Z-Elektrik/LIB/Library_Listing.ods

Sheet: Export for GitHUB
Filename/Library | Component | Description | ki_keywords | Reference | Value | Footprint | Datasheet | Technology | MFG | MPN | Device_Marking | OC_LCSC | OC_MOUSER | OC_RS | OC_DISTRELEC | OC_TME | OC_FARNELL | OC_DIGIKEY | OC_SOS | Z-SYSCODE | Assembly_Note | Comment
Audio_TDK.kicad_sym | PS1240P02BT, THD, 3V, 70dB, TDK | SMD Piezo element non polarised, 70 dB (4kHz), 3V | BZ | Y | PS1240P02BT | THD_Audio_TDK:SPKADVV500W65D1220H655-2N_PS12_TDK | https://product.tdk.com/system/files/dam/doc/product/sw_piezo/sw_piezo/piezo-buzzer/catalog/piezoelectronic_buzzer_ps_en.pdf | THD | TDK | PS1240P02BT |  | C76871 |  |  |  |  | 3267212
Connector_ETH_Wurth.kicad_sym | 7499010121A, THD, RJ45 8P8C Female, transf+2xLED, Horizontal, Wurth | RJ45 8P8C, Female, with transformer, with 2xLED, 16.1x25.4x13.55mm, Horizontal | ETH,RJ45 | X | 7499010121A | THD_Connector_ETH_Wurth:ETHRJ45_8P8C_7499010121A_Wurth | https://www.we-online.com/components/products/datasheet/7499010121A.pdf | THD | Wurth Elektronik | 7499010121A | 7499010121A |  | 710-7499010121A | 735-0239 | 300-63-255 |  | 1636379 | 732-1650-ND | 194844
Capacitor_Ceramic_THD5.00_100V_20-80perc_Y5V_Generic.kicad_sym | 100n, THD 5.00mm, 100V, 20%, Y5V, Generic | Capacitor ceramic, 100V, -20..+80%, Y5V | CCAP | C | 100n/100V | THD_Capacitor_Generic:CAPRB500W50D500T250H510 |  | THD | Generic |  |  |  |  |  |  |  |  |  |  | 1019
Capacitor_Ceramic_THD_JFZ_310V_10perc_X2_JBCapacitors.kicad_sym | 100n, THD 15.00mm, 310VAC, 10%, JBC | Capacitor X2 PP Foil, 310VAC, JFZ Series | CCAP,X2 | C | 100n/310VAC | THD_Capacitor_JBCap:CAPRR1500W90L1800T600H1200 | https://www.tme.eu/Document/13ccb7880bac8bd38632e7baf71c9910/JFZ-X2.pdf | THD | JB Capacitors | JFZ0A9104K150000B
Capacitor_Elyt_SMD_50V_20perc_LowESR_FK-Series_Panasonic.kicad_sym | 100u, SMD, 50V, 20%, Low ESR, Panasonic | Capacitor electrolytic, 50V, Low ESR, 2000-5000Hrs @105Â°C, FK Series | ECAP | C | 100u/50V | SMD_Capacitor_Elyt_Panasonic:CAPAE830X1020N_Panasonic-F | https://industrial.panasonic.com/cdbs/www-data/pdf/RDE0000/ABA0000C1181.pdf | SMD | Panasonic | EEEFK1H101P | 100 50 FK | C178548 | 667-EEE-FK1H101P | 537-0540 | 167-23-868 | EEEFK1H101P | 9695958 | PCE3809CT-ND |  | 6053
Capacitor_Elyt_THD2.50_63V_20perc_105C_1000H_Generic.kicad_sym | 47u, THD 2.5, 63V, 20%, Generic | Capacitor electrolytic, 63V, 20%, 1000Hrs @105Â°C | ECAP | C | 47u/63V | THD_Capacitor_Generic:CAPPRD250W70D630H1100 |  | THD | Generic |  |  |  |  |  |  |  |  |  |  | 678
Connector_USB_Ninigi.kicad_sym | USBB-BV, THD, USB-2.0-B, Vertical, Ninigi | PCB Connector, USB-2.0, Type B, 12x11x16.1mm, Vertical | USB | X | 2411 05 | THD_Connector_USB_Lumberg:CONNUSBV4W190P250H1610N-241105_Lumberg | https://www.tme.eu/Document/ad321a3664afd6b939251b221569d870/USBB-BV.pdf | THD | Ninigi | USBB-BV |  |  |  |  |  | USBB-BV |  |  |  | 2879
Diode_ONSemi.kicad_sym | ESD5Z3.3T1G, SOD523, Bidir, 3.3V, ON | ESD diode protection, Vrwm:3.3V, Vbr: 5.0V, It:1mA, Ppk:120W | TVS | Z | ESD5Z3.3T1G | SMD_Semiconductor_Generic:SODFL1608X70N_SOD-523_CASE502_ON | https://www.onsemi.com/pdf/datasheet/esd5z2.5t1-d.pdf | SMD | ON Semiconductor | ESD5Z3.3T1G | ZE | C61148 | 863-ESD5Z3.3T1G | 689-9985 |  | ESD5Z3.3T1G | 2317508 | ESD5Z3.3T1GOSCT-ND | 71556 | 8652
Diode_ONSemi.kicad_sym | LL4148, DO213AC, Signal diode, 100V, 200mA, ON | Diode Small Signal, Vrrm: 100V, If: 200mA, Ir<25nA, Vf<1.0V @10mA | D | D | LL4148 | SMD_Semiconductor_Generic:DIOMELF3414N_DO213AC_MiniMELF | https://www.tme.eu/Document/719e3c29769cb8dee605f959a3db8a4a/LL4148.pdf | SMD | ON Semiconductor | LL4148 |  | C84135 | 512-LL4148 | 670-8826 | 302-30-889 | LL4148-FAI | 2101203 | LL4148FSCT-ND | T372589 | 1138
Fuse_Eska.kicad_sym | 522.522, Mech, Glass fuse, 3.15A, 250VAC, Eska | Fuse cylindrical glass, Time-Lag, 5x20mm, 250VAC | Fuse | F | T3,15A |  | https://www.tme.eu/Document/9128035b9d50f6bbcf0a57f0845d1c57/22.pdf | Mechanical | Eska | 522.522 |  |  |  |  |  |  |  |  |  | 915
GDT_Epcos.kicad_sym | B88069X9590B502, THD, Gas disch. tube, 150V, 4kA, Epcos | Surge Arrester, Fast, 150V, 10kA, -40 to 125Â°C | GDT | Z | B88069X9590B502 | THD_GDT_Epcos:GDTAD880W100L1000D800-3N_Epcos | https://www.farnell.com/datasheets/3954723.pdf | THD | Epcos | B88069X9590B502 |  |  |  |  |  |  | 2529338
Header_Amphenol.kicad_sym | 77313-818-16LF, THD, 2x8pin, 2.54mm, h{colon}8.6mm, Gold, Male, Amphenol | Header Pins Dual Male, 2x8 pin, 2.54, h:8.6mm, Gold, THD | CON16,HEADER2x8 | X | 77313-818-16LF | THD_Header_Connfly:HDRV16W64P254H860N_2X8_PADC+R_170_170H100 | https://www.tme.eu/Document/e749bc1109c319ebf4eb6c9c60781caa/77313-818-XXLF.pdf | THD | Amphenol | 77313-818-16LF |  | C3338979 | 649-77313-818-16LF |  |  | 77313-818-16LF | 3882077 | 609-5139-ND |  | 1591
IC_Interface_NXP.kicad_sym | PCA9552BS, HVQFN24, 16-bit LED Driver, I2C, NXP | 16-bit I2C LED Driver 100mA with programmable blink rates, 5V, with A0,A1,A2 |  | U | PCA9552BS |  | https://www.nxp.com/docs/en/data-sheet/PCA9552.pdf | SMD | NXP | PCA9552BS |  | C2678763 | 771-PCA9552BS-T |  |  |  | 2775950 | 568-3389-1-ND
IC_Interface_NXP.kicad_sym | PCA9552D, SO24, 16-bit LED Driver, I2C, NXP | 16-bit I2C LED Driver 100mA with programmable blink rates, 5V, with A0,A1,A2 |  | U | PCA9552D |  | https://www.nxp.com/docs/en/data-sheet/PCA9552.pdf | SMD | NXP | PCA9552D |  | C2157803 | 771-PCA9552D-T |  |  | PCA9552D | 2985179 | 568-PCA9552D118CT-ND
IC_Interface_NXP.kicad_sym | PCA9552PW, TSSOP24, 16-bit LED Driver, I2C, NXP | 16-bit I2C LED Driver 100mA with programmable blink rates, 5V, with A0,A1,A2 |  | U | PCA9552PW |  | https://www.nxp.com/docs/en/data-sheet/PCA9552.pdf | SMD | NXP | PCA9552PW |  | C129513 | 771-PCA9552PW-T |  |  | PCA9552PW | 2775951 | 568-11924-1-ND | 287813
IC_Interface_NXP.kicad_sym | PCA9555D, SO24, 16-bit expander, I2C, NXP | 16-bit I2C expander with Interrupt |  | U | PCA9555D |  | http://www.nxp.com/documents/data_sheet/PCA9555.pdf | SMD | NXP | PCA9555D | PCA9555 |  | 771-PCA9555D112 |  | 663227 | PCA9555D | 8906076 |  |  | 9085
IC_Interface_NXP.kicad_sym | PCA9555PW, TSSOP24, 16-bit expander, I2C, NXP | 16-bit I2C expander with Interrupt |  | U | PCA9555PW |  | http://www.nxp.com/documents/data_sheet/PCA9555.pdf | SMD | NXP | PCA9555PW | PCA9555 |  |  |  |  |  |  |  |  | 7494
IC_Interface_NXP.kicad_sym | PCA9622DR, TSSOP32, 16-bit LED Driver, I2C, NXP | 16-bit I2C LED Driver 100mA, 40V |  | U | PCA9622 |  | https://www.nxp.com/docs/en/data-sheet/PCA9622.pdf | SMD | NXP | PCA9622DR |  |  | 771-PCA9622DR,118 |  |  |  | 1854075
IC_Interface_NXP.kicad_sym | PCA9633DP1, TSSOP8, 4-bit LED Driver, I2C, NXP | 4-bit I2C LED Driver 100mA, 40V |  | U | PCA9633DP1 |  | http://www.nxp.com/documents/data_sheet/PCA9633.pdf | SMD | NXP | PCA9633DP1 |  |  | 771-PCA9633DP1-T | 510-976
IC_Interface_NXP.kicad_sym | PCA9633DP2, TSSOP10, 4-bit LED Driver, I2C, NXP | 4-bit I2C LED Driver 100mA, 40V, With A0, A1 |  | U | PCA9633DP2 |  | http://www.nxp.com/documents/data_sheet/PCA9633.pdf | SMD | NXP | PCA9633DP2 |  |  | 771-PCA9633DP2-T | 510-908
IC_Interface_NXP.kicad_sym | PCA9952TW, HTSSOP28, 16-bit LED Driver, I2C, ExtRST, NXP | 16-bit I2C LED Driver 100mA, 40V, with Ext.RSET and OE | I2C,LED | U | PCA9952TW | SMD_IC_Generic:SOP65P640X110-29N_HTSSOP28_SOT1172-2_MO-153 | http://www.nxp.com/documents/data_sheet/PCA9952_PCA9955.pdf | SMD | NXP | PCA9952TW |  |  | 771-PCA9952TW118
IC_Interface_NXP.kicad_sym | PCA9955BTW, HTSSOP28, 16-bit LED Driver, I2C, ExtRST, NXP | 16-bit I2C LED Driver 57mA, 20V, with Ext.RSET | I2C,LED | U | PCA9955BTW | SMD_IC_Generic:SOP65P640X110-29N_HTSSOP28_SOT1172-2_MO-153 | https://www.nxp.com/docs/en/data-sheet/PCA9952_PCA9955.pdf | SMD | NXP | PCA9955BTWJ |  | C2678563 | 771-PCA9955BTWJ |  |  |  | 2759859 | 568-12427-1-ND | T547227 | 11090
IC_Interface_NXP.kicad_sym | PCA9955TW, HTSSOP28, 16-bit LED Driver, I2C, ExtRST, NXP | 16-bit I2C LED Driver 57mA, 40V, with Ext.RSET | I2C,LED | U | PCA9955TW | SMD_IC_Generic:SOP65P640X110-29N_HTSSOP28_SOT1172-2_MO-153 | https://www.nxp.com/docs/en/data-sheet/PCA9952_PCA9955.pdf | SMD | NXP | PCA9955BTWJ |  |  | 771-PCA9955TWQ900118 |  |  |  | 2890539 | 2156-PCA9955TW/S911118-ND
IC_Interface_STM.kicad_sym | ST3232CDR, SO16, 232 Transceiver, 400kbps, 3-5V, STM | 3-5V, 400 kbps RS-232 transceiver, 0 to 70Â°C | 232 | U | ST3232CDR | SMD_IC_STM:SOIC127P700X200-16N_SO-16_STM | https://www.farnell.com/datasheets/1766333.pdf | SMD | STMicroelectronics | ST3232CDR |  | C165465 | 511-ST3232CDR | 415-2105 | 303-74-345 | ST3232CDR | 2463693 | 497-3731-1-ND | T1106484
IC_Interface_STM.kicad_sym | ST3232EBDR, SO16, 232 Transceiver, 400kbps, 3-5V, STM | 3-5V, 400 kbps RS-232 transceiver, ESD, -40 to 85Â°C | 232 | U | ST3232EBDR | SMD_IC_STM:SOIC127P700X200-16N_SO-16_STM | https://www.tme.eu/Document/de702572cb81736231cab73a6afbf9f9/ST3232EB.pdf | SMD | STMicroelectronics | ST3232EBDR |  | C970561 | 511-ST3232EBDR | 426-099 |  | ST3232EBDR | 1467753 | 497-6996-1-ND | T1225455
IC_Interface_STM.kicad_sym | ST3485EBDR, SO8, 485/422 Transceiver, 3.3V, STM | 3.3V, 15 kV ESD protected, up to 12 Mbps RS-485/RS-422 transceiver, -40 to 85 Â°C | 485 | U | ST3485EBDR | SMD_IC_Generic:SOIC127P600X175-8N_SO-8_MS-012 | http://www.st.com/st-web-ui/static/active/en/resource/technical/document/datasheet/CD00003137.pdf | SMD | STMicroelectronics | ST3485EBDR | 3485EB | C75809 | 511-ST3485EBDR |  |  | ST3485EBD | 2253266 | 516-3164-5-ND | W008452 | 9425
IC_Interface_STM.kicad_sym | ST3485ECDR, SO8, 485/422 Transceiver, 3.3V, STM | 3.3V, 15 kV ESD protected, up to 12 Mbps RS-485/RS-422 transceiver, 0 to 70 Â°C | 485 | U | ST3485ECDR | SMD_IC_Generic:SOIC127P600X175-8N_SO-8_MS-012 | http://www.st.com/st-web-ui/static/active/en/resource/technical/document/datasheet/CD00003137.pdf | SMD | STMicroelectronics | ST3485ECDR | 3485EC | C81185 | 511-ST3485ECDR | 103-2150 |  | ST3485ECDR | 1842628 | 497-6540-1-ND | 134354
IC_Interface_STM.kicad_sym | ST485EBDR, SO8, 485/422 Transceiver, 5V, 5Mbps, STM | 5V, 15 kV ESD protected, 5 Mbps RS-485/RS-422 transceiver, - 40 to 85 Â°C | 485 | U | ST485EBDR | SMD_IC_Generic:SOIC127P600X175-8N_SO-8_MS-012 | https://www.st.com/resource/en/datasheet/st485eb.pdf | SMD | STMicroelectronics | ST485EBDR | 3485EB | C81186 | 511-ST485EBDR | 426-073 | 301-70-656 | ST485EBDR | 1467755 | 497-2083-1-ND | T1228758
IC_Interface_STM.kicad_sym | ST485ECDR, SO8, 485/422 Transceiver, 5V, 5Mbps, STM | 5V, 15 kV ESD protected, 5 Mbps RS-485/RS-422 transceiver, 0 to 70 Â°C | 485 | U | ST485ECDR | SMD_IC_Generic:SOIC127P600X175-8N_SO-8_MS-012 | https://www.st.com/resource/en/datasheet/st485eb.pdf | SMD | STMicroelectronics | ST485ECDR | 485EC | C283405 | 511-ST485ECDR | 686-4904 | 301-70-657 | ST485ECDR | 1842627 | 497-3735-1-ND | T1259145
IC_MCU32_NXP.kicad_sym | LPC5512JBD64, HTQFP64, ARM Cortex-M33, 64kB/48kB, 150MHz, NXP | 32-bit ARM Cortex-M33 microcontroller, 150MHz, 64kB Flash, 48kB SRAM, USB FS, CAN2.0, 2 Msps 16b ADC, 36 GPIO | MCU | U | LPC5512JBD64 | SMD_IC_NXP:QFP50P1200X1200X120-65N_HTQFP64_SOT855-5_NXP | https://www.nxp.com/part/MCXC242VLH | SMD | NXP | LPC5512JBD64 | LPC5512 JBD64 |  | 771-LPC5512JBD64E |  |  |  | 3385149 | 568-LPC5512JBD64YCT-ND
IC_MCU32_NXP.kicad_sym | LPC5514JBD64, HTQFP64, ARM Cortex-M33, 128kB/80kB, 150MHz, NXP | 32-bit ARM Cortex-M33 microcontroller, 150MHz, 128kB Flash, 80kB SRAM, USB FS+HS, CAN FD, 2 Msps 16b ADC, 36 GPIO | MCU | U | LPC5514JBD64 | SMD_IC_NXP:QFP50P1200X1200X120-65N_HTQFP64_SOT855-5_NXP | https://www.nxp.com/part/MCXC242VLH | SMD | NXP | LPC5514JBD64 | LPC5514 JBD64 | C1012832 | 771-LPC5514JBD64E |  |  |  | 3385147 | 568-LPC5514JBD64YCT-ND,568-LPC5514JBD64K-ND,568-LPC5514JBD64E-ND
IC_MCU32_NXP.kicad_sym | LPC5516JBD100, HTQFP100, ARM Cortex-M33, 256kB/96kB, 150MHz, NXP | 32-bit ARM Cortex-M33 microcontroller, 150MHz, 256kB Flash, 96kB SRAM, USB FS+HS, CAN FD, 2 Msps 16b ADC, 64 GPIO | MCU | U | LPC5516JBD100 | SMD_IC_NXP:QFP50P1600X1600X160-101N_HLQFP100_SOT1570-3_NXP | https://www.nxp.com/docs/en/nxp/data-sheets/LPC55S1x_LPC551x_DS.pdf | SMD | NXP | LPC5516JBD100 | LPC5516JBD100 | C5194658 | 771-LPC5516JBD100K |  |  | LPC5516JBD100E | 3385143 | 568-LPC5516JBD100K-ND | T1111149
IC_MCU32_NXP.kicad_sym | LPC5516JBD64, HTQFP64, ARM Cortex-M33, 256kB/96kB, 150MHz, NXP | 32-bit ARM Cortex-M33 microcontroller, 150MHz, 256kB Flash, 96kB SRAM, USB FS+HS, CAN FD, 2 Msps 16b ADC, 36 GPIO | MCU | U | LPC5516JBD64 | SMD_IC_NXP:QFP50P1200X1200X120-65N_HTQFP64_SOT855-5_NXP | https://www.nxp.com/docs/en/nxp/data-sheets/LPC55S1x_LPC551x_DS.pdf | SMD | NXP | LPC5516JBD64 | LPC5516 JBD64 | C1012835 | 771-LPC5516JBD64K,771-LPC5516JBD64E |  |  |  | 3385145 | 568-LPC5516JBD64E-ND,568-LPC5516JBD64K-ND,568-LPC5516JBD64YCT-ND |  | 12734
IC_MCU32_NXP.kicad_sym | LPC5528JBD64, HTQFP64, ARM Cortex-M33, 512kB/256kB, 150MHz, NXP | 32-bit ARM Cortex-M33 microcontroller, 150MHz, 512kB Flash, 256kB SRAM, USB FS+HS, SDIO, 1 Msps 16b ADC, 36 GPIO | MCU | U | LPC5528JBD64 | SMD_IC_NXP:QFP50P1200X1200X120-65N_HTQFP64_SOT855-5_NXP | https://www.nxp.com/part/MCXC242VLH | SMD | NXP | LPC5528JBD64 | LPC5528 JBD64 |  | 771-LPC5528JBD64E,771-LPC5528JBD64Y,771-LPC5528JBD64K |  |  | LPC5528JBD64E,LPC5528JBD64K,LPC5528JBD64Y | 3265622 | 568-LPC5528JBD64E-ND
IC_MCU32_NXP.kicad_sym | LPC824M201JDH20, TSSOP20, ARM Cortex-M0, 32kB/8kB, NXP | 32-bit ARM Cortex-M0 microcontroller, 32kB flash, 8kB SRAM, 16 GPIO | MCU | U | LPC824M201JDH20 | SMD_IC_Generic:SOP65P640X110-20N_TSSOP-20 | http://www.nxp.com/documents/data_sheet/LPC82X.pdf | SMD | NXP | LPC824M201JDH20 |  | C86812 |  |  |  |  |  |  |  | 12213
IC_MCU32_NXP.kicad_sym | LPC824M201JHI33, HVQFN32, ARM Cortex-M0, 32kB/8kB, 30MHz, NXP | 32-bit ARM Cortex-M0 microcontroller, 30MHz, 32kB flash, 8kB SRAM, 29 GPIO | MCU | U | LPC824M201JHI33 | SMD_IC_NXP:QFN50P500X500X100-33N_HVQFN32_NXP | https://www.nxp.com/docs/en/data-sheet/LPC82X.pdf | SMD | NXP | LPC824M201JHI33Y | 824M | C528755 | 771-LPC824M201JHI33Y |  |  |  | 2890181 | 568-13786-1-ND
IC_MCU32_NXP.kicad_sym | LPC844M201JHI33, HVQFN32, ARM Cortex-M0, 64kB/8kB, 30MHz, NXP | 32-bit ARM Cortex-M0 microcontroller, 30MHz, 64kB flash, 8kB SRAM, 29 GPIO | MCU | U | LPC844M201JHI33 | SMD_IC_NXP:QFN50P500X500X100-33N_HVQFN32_NXP |  | SMD | NXP | LPC844M201JHI33 | 844M | C2054839 | 771-LPC844M201JHI33Y |  |  |  | 2985173 | 568-LPC844M201JHI33YCT-ND
IC_MCU32_NXP.kicad_sym | LPC845M301JHI33, HVQFN32, ARM Cortex-M0, 64kB/16kB, 30MHz, NXP | 32-bit ARM Cortex-M0 microcontroller, 30MHz, 64kB flash, 16kB SRAM, 29 GPIO | MCU | U | LPC845M301JHI33 | SMD_IC_NXP:QFN50P500X500X100-33N_HVQFN32_NXP |  | SMD | NXP | LPC845M301JHI33Y | 845M | C2052902 | 771-LPC845M301JHI33Y |  |  |  | 2985175 | 568-14091-1-ND
IC_MCU32_NXP.kicad_sym | LPC865M201JHI33, HVQFN32, ARM Cortex-M0, 64kB/8kB, 60MHz, NXP | 32-bit ARM Cortex-M0 microcontroller, 60MHz, 64kB flash, 8kB SRAM, 29 GPIO | MCU | U | LPC865M201JHI33 | SMD_IC_NXP:QFN50P500X500X100-33N_HVQFN32_NXP | https://www.nxp.com/products/processors-and-microcontrollers/arm-microcontrollers/general-purpose-mcus/lpc800-arm-cortex-m0-plus-/lpc860-32-bit-arm-cortex-m0-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 | SMD | NXP | LPC865M201JHI33/0E | 865M |  | 771-PC865M201JHI330E |  |  |  |  | 568-LPC865M201JHI33/0E-ND
IC_MCU32_NXP.kicad_sym | MCXC242VFM, QFN32, ARM Cortex-M0+, 64kB/16kB, 48MHz, NXP | 32-bit ARM Cortex-M0+ microcontroller, 48MHz, 64kB Flash, 16kB SRAM, USB, 24 GPIO | MCU | U | MCXC242VFM | SMD_IC_NXP:QFN50P500X500X58-33N_HUQFN32_NXP | https://www.nxp.com/part/MCXC242VFM | SMD | NXP | MCXC242VFM | MC242M |  | 771-MCXC242VFM |  |  |  | 4557994 | 568-MCXC242VFM-ND
IC_MCU32_NXP.kicad_sym | MCXC242VLH, LQFP64, ARM Cortex-M0+, 64kB/16kB, 48MHz, NXP | 32-bit ARM Cortex-M0+ microcontroller, 48MHz, 64kB Flash, 16kB SRAM, USB, 51 GPIO | MCU | U | MCXC242VLH | SMD_IC_NXP:QFP50P1200X1200X120-65N_HTQFP64_SOT855-5_NXP | https://www.nxp.com/part/MCXC242VLH | SMD | NXP | MCXC242VLH | MCXC242/VLH |  | 771-MCXC242VLH |  |  |  | 4557993 | 568-MCXC242VLH-ND
Opto_Ampul.kicad_sym | AM4140, THD, Rectangle 2x5mm, Flat, Yellow, 20mA, Ampul | LED, Rectangle 2x5x7mm, Yellow 585nm, Lens:Flat, Water Clear, No-Flange, 600mcd@20mA, 160Â°, Vf: 1.8-2.2V@20mA | LED | D | AM4140-Yellow | THD_Opto_Generic:LEDRR254W50L500T200H700-2N_FLT_NF_LL600_White | https://www.ampul.eu/cs/led-obdelnikove/2973-led-dioda-obdelnikova-2x5x7mm-zluta-cira | THD |  |  |  |  |  |  |  |  |  |  |  | 1722 |  | Ampul.eu->order code: AM4140
Opto_Ampul.kicad_sym | AM8774, THD, Rectange 2x5mm, Flat, Green, 20mA, Ampul | LED, Rectangle 2x5x7mm, Green 517nm, Lens:Flat, Water Clear, No-Flange, 1500mcd@20mA, 160Â°, Vf: 3.0-3.4V@20mA | LED | D | AM8774-Green | THD_Opto_Generic:LEDRR254W50L500T200H700-2N_FLT_NF_LL600_White | https://www.ampul.eu/cs/led-obdelnikove/2971-led-dioda-obdelnikova-2x5x7mm-zelena-cira | THD |  |  |  |  |  |  |  |  |  |  |  | 3928 |  | Ampul.eu->order code: AM8774
Opto_Ampul.kicad_sym | AM8957, THD, Rectange 2x5mm, Flat, Red, 20mA, Ampul | LED, Rectangle 2x5x7mm, Red 625nm, Lens:Flat, Water Clear, No-Flange, 800mcd@20mA, 160Â°, Vf: 1.8-2.2V@20mA | LED | D | AM8957-Red | THD_Opto_Generic:LEDRR254W50L500T200H700-2N_FLT_NF_LL600_White | https://www.ampul.eu/cs/led-obdelnikove/2975-led-dioda-obdelnikova-2x5x7mm-cervena-cira | THD |  |  |  |  |  |  |  |  |  |  |  | 5261 |  | Ampul.eu->order code: AM8957
IC_Power_TopPowerASIC.kicad_sym | TP5400, ESOP8, Li-lon Battery Charger, 0.13-1.0A, VBat 3.8V, TopPowerAsic | Li-Ion Charger and boost, Bat: 4.2V, Vi: max 9V, Vo: 5V, 0.13-1.0A, 400kHz, -40 to 85Â°C | IC | U | TP5400 | SMD_IC_TopPowerASIC:SOIC127P600X175-9N_ESOP-8_TOPPWR | http://toppwr.com/uploadfile/file/20240913/66e3d16e96d7b.pdf | SMD | NanJing Top Power ASIC Corp. | TP5400-ESOP8 |  | C2891434
IC_Power_TopPowerASIC.kicad_sym | TP5410, ESOP8, Li-lon Battery Charger, 0.13-1.0A, VBat 3.8V, TopPowerAsic | Li-Ion Charger and boost, Bat: 4.2V, Vi: max 10V, Vo: 5V, 0.13-1.0A, 400kHz, -40 to 85Â°C | IC | U | TP5410 | SMD_IC_TopPowerASIC:SOIC127P600X175-9N_ESOP-8_TOPPWR | http://www.toppwr.com/uploadfile/file/20240913/66e3a6134c8db.pdf | SMD | NanJing Top Power ASIC Corp. | TP5410-ESOP8 |  | C2891434
IC_Socket_Connfly.kicad_sym | DS1001-01-32BT1WSF6S-JKB, IC Socket, DIP32, ConnFly | IC Socket, DIP32, RM2.54mm, Width:15.24mm, Height:4.7mm, with Central Support, Precise, Gold Plating 3um | IC,Socket | U |  | THD_IC_Socket_Connfly:DIPS1524W50P254L4064H470Q32-N_Connfly | https://www.tme.eu/Document/4e675710cbbe7d2c7527f172074a3ea6/DS1001-01.pdf | THD | ConnFly | DS1001-01-32BT1WSF6S-JKB |  | C72128 |  |  |  |  |  |  |  | 5871
Inductor_Schmid.kicad_sym | K5A SDRH-3.5x4.5x0.8, THD, 60Ohm, Schmid | Ferrite Bead for wire, Z: 60Î©, -55 to 125Â°C, Mat: K5A, SDRH Series | IND | L | 60Î© | THD_Inductor_Schmid:INDAD1300W65L45D35 | http://www.smsk.sk/images/8_SDRH.pdf | THD | Schmid | K5A SDRH3,5x4,5x0,8 |  |  |  |  |  |  |  |  |  | 5571 |  | Alt: K5B RH-3.5x4.5x0.8-T26
Inductor_Schmid.kicad_sym | SCB160808A-601, SMD 0603, 1A, 600Ohm, Schmid | Chip Ferrite Bead, 1A, Rdc: 200mÎ©, Z: 600Î©, 25%, -55 to 125Â°C, SCB-A Series | IND | L | 600Î©/1A | SMD_Inductor_Generic:INDC1608X80N_0603 | https://www.angiela-elektronik.ro/ferite+inductori/SCHMID-M_EMC%202016.pdf | SMD | Schmid | SCB160808A-601 |  |  |  |  |  |  |  |  |  | 11950
Inductor_Schmid.kicad_sym | SCB321611A-601/2, SMD 1206, 2A, 600Ohm, Schmid | Chip Ferrite Bead, 2A, Rdc: 100mÎ©, Z: 600Î©, 25%, -55 to 125Â°C, SCB-A Series | IND | L | 600Î©/2A | SMD_Inductor_Generic:INDC3216X110N_1206 | https://www.angiela-elektronik.ro/ferite+inductori/SCHMID-M_EMC%202016.pdf | SMD | Schmid | SCB321611A-601/2 |  |  |  |  |  |  |  |  |  | 1947
Inductor_Schmid.kicad_sym | SPRH1207-101M, SMD 12x12x8, 100uH, 1.7A, 220mOhm, Schmid | Inductor Power Shielded, 1.7A, Rdc: 220mÎ©, Body: 12x12x8mm, SPRH-DD Series | IND | L | 100uH/1.7A | SMD_Inductor_Schmid:INDP12001200X800N | http://www.schmid-multitech.sk/images/62_SPRH.pdf | SMD | Schmid | SPRH1207-101M | 101 |  |  |  |  |  |  |  |  | 6118
Inductor_TDK.kicad_sym | MLZ2012N100LTD25, SMD 0805, 10uH, 110mA, 300mOhm, TDK | Chip Multilayer Ferrite Inductor, 110mA, Rdc: 300mÎ©, 20%, -55 to 125Â°C, MLZ 2012 Series | IND | L | 10uH/110mA | SMD_Inductor_Generic:INDC2012X145N_0805 | https://product.tdk.com/system/files/dam/doc/product/inductor/inductor/smd/catalog/inductor_automotive_decoupling_mlz2012_en.pdf | SMD | TDK | MLZ2012N100LTD25 |  | C88183 | 810-MLZ2012N100LTD25 |  |  | MLZ2012N100LTD25 | 3516865 | 445-16376-1-ND |  | 10784
Opto_Optoflash.kicad_sym | OF-SMD1608B, SMD 0603, Blue, 20mA, Optoflash | LED, Blue, Rectangle, 1.6x0.8mm, 250mcd, 120Â°, Water Clear Front, 20mA, Vf: 3.0V | LED | D | OF-SMD1608B | SMD_LED_Generic:LEDC1608X110-2N_0603_Blue | https://grobotronics.com/images/datasheets/of-smd1608b.pdf | SMD | Optoflash | OF-SMD1608B |  |  |  |  |  | OF-SMD1608B |  |  |  | 8182 |  | 3D model isn't appropriate!
Switch_CTS.kicad_sym | 206-4, SMD, Switch DIP 4x, 100mA, 6V, Vertical, CTS | Switch DIP 4x, 100mA, 50VDC, Vertical | Switch,Button | S | Switch DIP 4 | THD_Switch_CTS:DIP762W40P254L1234H760Q8 | https://www.mouser.sk/datasheet/2/96/206-1770993.pdf | SMD | CTS | 206-4 |  | C3012342 | 774-2064
ResVariable_Vishay.kicad_sym | T7YA102MT20, R-TRIM 1k, 500mW, 1 turn, Top Adjustment | 7mm Circle Single-Turn Cermet Trimmer | RV | R | 10k | THD_ResVar_Vishay:RESVAR_T7YA_VISHAY | https://www.vishay.com/doc?51026 | THD | Vishay | T7YA102MT20 |  | C5954087 | 72-T7YA102MT20 | 374-6743 |  |  | 3997591 | 716-T7YA102MT20-ND | 79747 | 5689
ResVariable_Vishay.kicad_sym | T93YB103KT20, R-TRIM 10k, 500mW, 21 turns, Top Adjustment | 3/8\ | RV | R | 10k | THD_ResVar_Vishay:RESVAR_T93Y_VISHAY | https://www.vishay.com/doc?51026 | THD | Vishay | T93YB103KT20 |  | C5334355 | 72-T93YB-10K | 788-5114 |  | T93YB10K |  | T93YB-10K-ND |  | 3453
TVS_STM.kicad_sym | P6SMB10CA | Transient suppresion diode, P6SMB series, bidirectional, 600W, SMD, Littelfuse | TVS | Z | 10V | SMD_Semiconductor_Generic:DIOM5539X261N_DO214AA_SMB-J | https://www.littelfuse.com/media?itemid=d4d777fb-374b-42c4-a3d8-20066dec10f6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 | SMD | Littelfuse | P6SMB10CA |  |  | 576-P6SMB10CA |  |  | P6SMB10CA-LF |  |  |  | 8127
TVS_STM.kicad_sym | P6SMB15CA | Transient suppresion diode, P6SMB series, bidirectional, 600W, SMD, Littelfuse | TVS | Z | 15V | SMD_Semiconductor_Generic:DIOM5539X261N_DO214AA_SMB-J | https://www.littelfuse.com/media?itemid=d4d777fb-374b-42c4-a3d8-20066dec10f6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 | SMD | Littelfuse | P6SMB15CA |  |  | 576-P6SMB15CA |  |  | P6SMB15CA-LF | 1886330 |  |  | 3878
TVS_STM.kicad_sym | P6SMB6.8CA | Transient suppresion diode, P6SMB series, bidirectional, 600W, SMD, Littelfuse | TVS | Z | 6V8 | SMD_Semiconductor_Generic:DIOM5539X261N_DO214AA_SMB-J | https://www.littelfuse.com/media?itemid=d4d777fb-374b-42c4-a3d8-20066dec10f6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 | SMD | Littelfuse | P6SMB6.8CA |  |  | 576-P6SMB6.8CA |  |  | P6SMB6.8CA-LF | 1886341 |  | 5525 | 3480
TVS_STM.kicad_sym | SM6T33A, DO214AA, Unidir, 33V, STM | TVS diode, Unidirectional, Vbr: 33V, SM6T series, unidirectional, 600W | TVS | Z | 33V | SMD_Semiconductor_Generic:DIOM5539X261N_DO214AA_SMB-J | https://www.tme.eu/Document/6de1e7315a2889731dd058e46baa50b3/SM6T33A.pdf | SMD | STMicroelectronics | SM6T33A | ET | C133690 |  | 486-5003 | 170-40-058 | SM6T33A | 9802673 | 497-6493-1-ND | T832123 | 10117
TVS_STM.kicad_sym | USBLC6-2SC6, SOT23-6, 2 DataLine, 6V, STM | ESD Protection diodes, Very low capacitance, Vbr: 6V, USB, HDMI, ETH | ESD | Z | USBLC6-2SC6 | SMD_Semiconductor_Generic:SOT95P280X145-6N_SOT23-6L | https://www.mouser.sk/datasheet/2/389/usblc6_2-1852789.pdf | SMD | STMicroelectronics | USBLC6-2SC6 |  | C7519 | 511-USBLC6-2SC6 | 624-7693 | 300-34-148 | USBLC6-2SC6 | 1269406 | 497-5235-1-ND | 77265 | 8252
Terminal_Sauro.kicad_sym | CIM020M1, 2p, 5.00, vertical | PCB Terminal, Header, 5.00 mm, 1x2 pin, 300V, 16A, Open sides, Vertical | XC | X | CIM020M1 | THD_Terminal_Sauro:HDRV2W140P500N_1X2_1000X835X1200_Sauro | https://www.sauro.net/products/CIM020M1/?product_id=CIM020M1 | THD | Sauro | CIM020M1
Terminal_Sauro.kicad_sym | CIM020M5, 2p, 5.08, vertical | PCB Terminal, Header, 5.08 mm, 1x2 pin, 300V, 16A, Open sides, Vertical | XC | X | CIM020M5 |  | https://www.sauro.net/product/CiM020M5/ | THD | Sauro | CIM020M5 |  |  |  |  |  |  |  | 5746-CIM020M5-ND |  | 3763
Terminal_Sauro.kicad_sym | CIM029P5, 2p, 5.08, horizontal | PCB Terminal, Header, 5.08 mm, 1x2 pin, 300V, 16A, Closed sides, Horizontal/90Â°/Right Angle | XC | X | CIM029P5 | THD_Terminal_Sauro:HDRV2W140P508N_1X2_1198X1200X835_Sauro | https://www.sauro.net/products/CIM029P5/?product_id=CIM029P5 | THD | SAURO srl | CIM029P5 |  |  |  |  |  |  |  |  |  | 4921
Terminal_Sauro.kicad_sym | CIM030M1, 3p, 5.00, vertical | PCB Terminal, Header, 5.00 mm, 1x3 pin, 16A, 300V, Open Sides, Vertical | XC | X | CIM030M1 | THD_Terminal_Sauro:HDRV3W140P500N_1X3_1500X835X1200_Sauro | https://www.sauro.net/products/CIM030M1/?product_id=CIM030M1&usableWith=CF | THD | Sauro | CIM030M1
Terminal_Sauro.kicad_sym | CIM040M1, 4p, 5.00, vertical | PCB Terminal, Header, 5.00 mm, 1x4 pin, 16A, 300V, Open Sides, Vertical | XC | X | CIM040M1 | THD_Terminal_Sauro:HDRV4W140P500N_1X4_2000X835X1200_Sauro | https://www.sauro.net/products/CIM040M1/?product_id=CIM040M1&usableWith=CF | THD | Sauro | CIM040M1
Terminal_Sauro.kicad_sym | CIM050M1, 5p, 5.00, vertical | PCB Terminal, Header, 5.00 mm, 1x5 pin, 16A, 300V, Open Sides, Vertical | XC | X | CIM050M1 | THD_Terminal_Sauro:HDRV5W140P500N_1X5_2500X835X1200_Sauro | https://www.sauro.net/products/CIM050M1?product_id=CIM050M1&usableWith=CF | THD | Sauro | CIM050M1
Terminal_Sauro.kicad_sym | CIM060M1, 6p, 5.00, vertical | PCB Terminal, Header, 5.00 mm, 1x6 pin, 16A, 300V, Open Sides, Vertical | XC | X | CIM060M1 | THD_Terminal_Sauro:HDRV6W140P500N_1X6_3000X835X1200_Sauro | https://www.sauro.net/products/CIM060M1?product_id=CIM060M1&usableWith=CF | THD | Sauro | CIM060M1
Terminal_Sauro.kicad_sym | CIM070M1, 7p, 5.00, vertical | PCB Terminal, Header, 5.00 mm, 1x7 pin, 16A, 300V, Open Sides, Vertical | XC | X | CIM070M1 | THD_Terminal_Sauro:HDRV7W140P500N_1X7_3500X835X1200_Sauro | https://www.sauro.net/products/CIM070M1?product_id=CIM070M1&usableWith=CF | THD | Sauro | CIM070M1
Terminal_Sauro.kicad_sym | CIM080M1, 8p, 5.00, vertical | PCB Terminal, Header, 5.00 mm, 1x8 pin, 16A, 300V, Open Sides, Vertical | XC | X | CIM080M1 | THD_Terminal_Sauro:HDRV8W140P500N_1X8_4000X835X1200_Sauro | https://www.sauro.net/products/CIM080M1?product_id=CIM080M1&usableWith=CF | THD | Sauro | CIM080M1
Terminal_Sauro.kicad_sym | CIM090M1, 9p, 5.00, vertical | PCB Terminal, Header, 5.00 mm, 1x9 pin, 16A, 300V, Open Sides, Vertical | XC | X | CIM090M1 | THD_Terminal_Sauro:HDRV9W140P500N_1X9_4500X835X1200_Sauro | https://www.sauro.net/products/CIM090M1?product_id=CIM090M1&usableWith=CF | THD | Sauro | CIM090M1
Terminal_Sauro.kicad_sym | CIM100M1, 10p, 5.00, vertical | PCB Terminal, Header, 5.00 mm, 1x10 pin, 16A, 300V, Open Sides, Vertical | XC | X | CIM100M1 | THD_Terminal_Sauro:HDRV10W140P500N_1X10_5000X835X1200_Sauro | https://www.sauro.net/products/CIM100M1?product_id=CIM100M1&usableWith=CF | THD | Sauro | CIM100M1
Terminal_Sauro.kicad_sym | CIM110M1, 11p, 5.00, vertical | PCB Terminal, Header, 5.00 mm, 1x11 pin, 16A, 300V, Open Sides, Vertical | XC | X | CIM110M1 | THD_Terminal_Sauro:HDRV11W140P500N_1X11_5500X835X1200_Sauro | https://www.sauro.net/products/CIM110M1?product_id=CIM110M1&usableWith=CF | THD | Sauro | CIM110M1
Terminal_Sauro.kicad_sym | CIM120M1, 12p, 5.00, vertical | PCB Terminal, Header, 5.00 mm, 1x12 pin, 16A, 300V, Open Sides, Vertical | XC | X | CIM120M1 | THD_Terminal_Sauro:HDRV12W140P500N_1X12_6000X835X1200_Sauro | https://www.sauro.net/products/CIM120M1?product_id=CIM120M1&usableWith=CF | THD | Sauro | CIM120M1
Terminal_Sauro.kicad_sym | CIM130M1, 13p, 5.00, vertical | PCB Terminal, Header, 5.00 mm, 1x13 pin, 16A, 300V, Open Sides, Vertical | XC | X | CIM130M1 | THD_Terminal_Sauro:HDRV13W140P500N_1X13_6500X835X1200_Sauro | https://www.sauro.net/products/CIM130M1?product_id=CIM130M1&usableWith=CF | THD | Sauro | CIM130M1
Terminal_Sauro.kicad_sym | CIM140M1, 14p, 5.00, vertical | PCB Terminal, Header, 5.00 mm, 1x14 pin, 16A, 300V, Open Sides, Vertical | XC | X | CIM140M1 | THD_Terminal_Sauro:HDRV14W140P500N_1X14_7000X835X1200_Sauro | https://www.sauro.net/products/CIM140M1?product_id=CIM140M1&usableWith=CF | THD | Sauro | CIM140M1
Terminal_Sauro.kicad_sym | CIM150M1, 15p, 5.00, vertical | PCB Terminal, Header, 5.00 mm, 1x15 pin, 16A, 300V, Open Sides, Vertical | XC | X | CIM150M1 | THD_Terminal_Sauro:HDRV15W140P500N_1X15_7500X835X1200_Sauro | https://www.sauro.net/products/CIM150M1?product_id=CIM150M1&usableWith=CF | THD | Sauro | CIM150M1
Terminal_Sauro.kicad_sym | CIM160M1, 16p, 5.00, vertical | PCB Terminal, Header, 5.00 mm, 1x16 pin, 16A, 300V, Open Sides, Vertical | XC | X | CIM160M1 | THD_Terminal_Sauro:HDRV16W140P500N_1X16_8000X835X1200_Sauro | https://www.sauro.net/products/CIM160M1?product_id=CIM160M1&usableWith=CF | THD | Sauro | CIM160M1
Terminal_Sauro.kicad_sym | CIM180M1, 18p, 5.00, vertical | PCB Terminal, Header, 5.00 mm, 1x18 pin, 16A, 300V, Open Sides, Vertical | XC | X | CIM180M1 | THD_Terminal_Sauro:HDRV18W140P500N_1X18_9000X835X1200_Sauro | https://www.sauro.net/products/CIM180M1?product_id=CIM180M1&usableWith=CF | THD | Sauro | CIM180M1
Transistor_Diotec.kicad_sym | BC337-16, TO92, NPN, 45V, 800mA, Diotec | Transistor NPN, THD, 45V, 0.8A, 625mW, hFE:160, TO-92, Diotec | NPN | Q | BC337-16 | THD_Transistor_Generic:TO92-TO226AA-123-BentLleadInline | https://diotec.com/request/datasheet/bc337.pdf | THD | Diotec | BC337-16 |  | C3201617 | 637-BC337-16 |  | 301-46-539 | BC337-16-DIO |  | 4878-BC337-16-ND | 294741
Transistor_Diotec.kicad_sym | BC337-25, TO92, NPN, 45V, 800mA, Diotec | Transistor NPN, THD, 45V, 0.8A, 625mW, hFE:250, TO-92, Diotec | NPN | Q | BC337-25 | THD_Transistor_Generic:TO92-TO226AA-123-BentLleadInline | https://diotec.com/request/datasheet/bc337.pdf | THD | Diotec | BC337-25 |  | C3201592 | 637-BC337-25 |  | 171-01-458 | BC337-25-DIO |  | 4878-BC337-25CT-ND | 294743 | 211
Transistor_Diotec.kicad_sym | BC337-40, TO92, NPN, 45V, 800mA, Diotec | Transistor NPN, THD, 45V, 0.8A, 625mW hFE:400, TO-92, Diotec | NPN | Q | BC337-40 | THD_Transistor_Generic:TO92-TO226AA-123-BentLleadInline | https://diotec.com/request/datasheet/bc337.pdf | THD | Diotec | BC337-40 |  | C3201595 | 637-BC337-40 |  | 171-01-459 | BC337-40-DIO |  | 4878-BC337-40CT-ND | 75749 | 164
Transistor_Diotec.kicad_sym | BC546B, TO92, NPN, 65V, 100mA, Diotec | Transistor NPN, THD, 65V, 0.1A, 500mW TO-92, Diotec | NPN | Q | BC546B | THD_Transistor_Generic:TO92-TO226AA-123-BentLleadInline | https://diotec.com/request/datasheet/bc546.pdf | THD | Diotec | BC546B |  | C3201532 | 637-BC546B |  | 302-53-679 | BC546B-DIO |  | 4878-BC546BCT-ND | 75752 | 1322
Transistor_Diotec.kicad_sym | BC808-40, SOT23, 25V, 800mA, Diotec | Transistor PNP, 25V, 800mA, hFE:250-630, 0.31W, SOT-23, Nexperia | PNP | Q | BC808-40 | SMD_Semiconductor_Generic:SOT95P250X110-3N_SOT23-3 | https://diotec.com/request/datasheet/bc807.pdf | SMD | Diotec | BC808-40 | 5G, 5CT |  | 637-BC808-40 |  |  | BC808-40-DIO | 4710305 | 4878-BC808-40CT-ND | 294777 | 12859
Transistor_Diotec.kicad_sym | MPSA92, TO92, PNP, 300V, 500mA, Diotec | Transistor PNP, THD, 300V, 0.5A, 625mW hFE:40, TO-92, Diotec | PNP | Q | MPSA92 | THD_Transistor_Generic:TO92-TO226AA-123-BentLleadInline | https://diotec.com/request/datasheet/mpsa92.pdf | THD | Diotec | MPSA92 |  | C3201614 | 637-MPSA92 |  | 302-53-774 | MPSA92-DIO |  | 4878-MPSA92CT-ND | 295659 | 7333
1_Generic_Symbol.kicad_sym | Button | Switch pushbutton | Switch,Button | S | Button |  |  | SMD
1_Generic_Symbol.kicad_sym | CAPFIL | Capacitor filter | CAPFIL | C | CAPFIL | SMD_Capacitor_NonPolarised_Generic:CAPC1608X30N_0603 |  | SMD
1_Generic_Symbol.kicad_sym | CCAP | Capacitor ceramic | CCAP | C | CCAP | SMD_Capacitor_NonPolarised_Generic:CAPC1608X30N_0603 |  | SMD
1_Generic_Symbol.kicad_sym | CON6 | Connector 6 pin, Male | CON6 | X | CON6 | Z-HEADER_PCB_HEADER_1X6-2.54MM-0.9MM |  | SMD
1_Generic_Symbol.kicad_sym | D | Diode | D | D | D |  |  | SMD
1_Generic_Symbol.kicad_sym | D-Capacitance, Varactor, Varicap | Varicap | D | D | D |  |  | SMD
1_Generic_Symbol.kicad_sym | D-SCHOTTKY | Diode Schottky | D | D | D-SCHOTTKY |  |  | SMD
1_Generic_Symbol.kicad_sym | D-SCHOTTKY_DUAL_CA | Diode Schottky Dual Common Anode | D | D | D-SCHOTTKY_DUAL_CA |  |  | SMD
1_Generic_Symbol.kicad_sym | D-SCHOTTKY_DUAL_CC | Diode Schottky Dual Common Cathode | D | D | D-SCHOTTKY_DUAL_CC |  |  | SMD
1_Generic_Symbol.kicad_sym | D-Zener | Diode Zener | ZD | D | ZD |  |  | SMD
1_Generic_Symbol.kicad_sym | ECAP | Capacitor Electrolytic | ECAP | C | ECAP |  |  | SMD
1_Generic_Symbol.kicad_sym | ElectromagneticRepro_Polarised | Electromagnetic element polarised | BZ | Y | ElectromagneticRepro_Polarised |  |  | SMD
1_Generic_Symbol.kicad_sym | Fuse | Fuse | Fuse | F | Fuse |  |  | SMD
1_Generic_Symbol.kicad_sym | Gate_Single_NAND_A_B_Y_POWER |  | IC | U | Gate_NAND_A_B_Y |  |  | SMD
1_Generic_Symbol.kicad_sym | Inductor | Inductor withou core | IND | L | Ind |  |  | SMD
1_Generic_Symbol.kicad_sym | Inductor dual | Inductor dual with core | Ind | L | Inductor |  |  | THD
1_Generic_Symbol.kicad_sym | LED | LED Diode | LED | D | LED |  |  | SMD
1_Generic_Symbol.kicad_sym | LED-Blue | LED-Blue | LED | D | LED-Blue |  |  | THD
1_Generic_Symbol.kicad_sym | LED-Green | LED-Green | LED | D | LED-Green |  |  | THD
1_Generic_Symbol.kicad_sym | LED-Orange | LED-Orange | LED | D | LED-Orange |  |  | THD
1_Generic_Symbol.kicad_sym | LED-Red | LED-Red | LED | D | LED-Red |  |  | THD
1_Generic_Symbol.kicad_sym | LED-Yellow | LED-Yellow | LED | D | LED-Yellow |  |  | THD
1_Generic_Symbol.kicad_sym | Mechanical Component | Virtual mechanical component only for BOM |  | ME | DPS skl. nĂˇzov |  |  |  |  |  |  |  |  |  |  |  |  |  |  | xxxx | komentĂˇr
1_Generic_Symbol.kicad_sym | OpaAmp | Single 2â€“Input OpaAmp | opamp | U | OpAmp | SMD_IC_Generic:SOIC127P600X175-8N_SO-8_MS-012 |  | SMD | Generic
1_Generic_Symbol.kicad_sym | Opto_AC_Darlington_Single |  |  | U | Opto |  |  | SMD
1_Generic_Symbol.kicad_sym | Opto_AC_EN_OUT_INV |  |  | U | Opto |  |  | SMD
1_Generic_Symbol.kicad_sym | Opto_AC_Single |  |  | U | Opto |  |  | SMD
1_Generic_Symbol.kicad_sym | Opto_Dig_Double_Inv |  |  | U | Opto |  |  | SMD
1_Generic_Symbol.kicad_sym | Opto_Dig_Signle_Inv |  |  | U | Opto |  |  | SMD
1_Generic_Symbol.kicad_sym | Opto_Dig_Single_Inv_EN |  |  | U | Opto |  |  | SMD
1_Generic_Symbol.kicad_sym | PTC | Polymer PTC Fuse | PTC | R | PTC |  |  | SMD
1_Generic_Symbol.kicad_sym | PiezoRepro_NonPolarised | Piezo element non polarised | BZ | Y | PiezoRepro_NonPolarised |  |  | SMD
1_Generic_Symbol.kicad_sym | PiezoRepro_Polarised | Piezo element polarised | BZ | Y | PiezoRepro_Polarised |  |  | SMD
1_Generic_Symbol.kicad_sym | RES | Resistor | RES | R | RES |  |  | SMD
1_Generic_Symbol.kicad_sym | RES-POT | Resistor Potentiometer | RP | R |  |  |  | SMD
1_Generic_Symbol.kicad_sym | RES-Pack-4-AllInOne | Resistor | RES | R | RES |  |  | SMD
1_Generic_Symbol.kicad_sym | RES-Pack-4-Single | Resistor | RES | R | RES |  |  | SMD
1_Generic_Symbol.kicad_sym | RES-TRIM | Resistor trimmer | RV | R |  |  |  | SMD
1_Generic_Symbol.kicad_sym | Relay - DPDT (Dual Pole Dual Throw) | Relay - DPDT (Dual Pole Dual Throw) | Relay | K | Relay - DPDT (Dual Pole Dual Throw) |  |  | THD
1_Generic_Symbol.kicad_sym | Relay - SPDT (Single Pole Dual Throw) | Relay - SPDT (Single Pole Dual Throw) | Relay | K | Relay - SPDT (Single Pole Dual Throw) |  |  | THD
1_Generic_Symbol.kicad_sym | Surge protector |  | TBU | Z |  |  |  | SMD
1_Generic_Symbol.kicad_sym | Switch DIP 4 |  | Switch,Button | S | Switch DIP 4 |  |  | SMD
1_Generic_Symbol.kicad_sym | Switch rotary |  | Switch,Button | S | Switch rotary |  |  | SMD
1_Generic_Symbol.kicad_sym | TRANS-N-FET_w_Diode | Transistor FET N-Channel | T | Q | TRANS-NFET |  |  | SMD
1_Generic_Symbol.kicad_sym | TRANS-N-JFET | Transistor JFET N-Channel | T,JFET | Q | TRANS-NJFET |  |  | SMD
1_Generic_Symbol.kicad_sym | TRANS-NPN | Transistor | T | Q | TRANS-NPN |  |  | SMD
1_Generic_Symbol.kicad_sym | TRANS-Opto | Diode | D | Y | TRANS-Opto |  |  | SMD
1_Generic_Symbol.kicad_sym | TRANS-P-FET_w_Diode | Transistor FET P-Channel | T | Q | TRANS-PFET |  |  | SMD
1_Generic_Symbol.kicad_sym | TRANS-PNP | Transistor | T | Q | TRANS-PNP |  |  | SMD
1_Generic_Symbol.kicad_sym | TVS-BIDIR | Transient voltage suppressor, Bidirectional | TVS | Z | TVS-BIDIR |  |  | SMD
1_Generic_Symbol.kicad_sym | TVS-UNI | Transient voltage suppressor, Unidirectional |  | Z | TVS-UNI |  |  | SMD
1_Generic_Symbol.kicad_sym | Terminal PCB 1P for wire | Terminal PCB 1P for wire | XC | X | Terminal |  |  | THD
1_Generic_Symbol.kicad_sym | Terminal PCB 2P for wire | Terminal PCB 2P for wire | XC | X | Terminal |  |  | THD
1_Generic_Symbol.kicad_sym | Terminal block, 2p, Screw | PCB Terminal block, Screw, 5.08 mm, 1x2 pin, Straight, Side entry | XC | X | Terminal block, 2p, Screw |  |  | THD
1_Generic_Symbol.kicad_sym | Varistor | Metal-oxide Varistor | MOV | Z | Varistor |  |  | THD
Switch_Diptronics.kicad_sym | DTS63K, THD 6.2x6.2mm, SwitchTactile, Black Cap, w/o GND Pin 1.0N, Vertical, Diptronics | Switch Tactile, SPST NO, 6.2x6.2mm, 50mA, 12VDC, 1.0N, vertical | Switch,Button,Tactile | S | DTS63K | THD_Switch_Diptronics:SW_PUSH_620X620H700-4N_Diptronics | https://www.tme.eu/Document/59ad2357d9e494ad618a716e15a5da58/DTSG-6.pdf | THD | Diptronics | DTS63K |  |  |  |  |  | DTS63K |  |  |  | 3668
Switch_Diptronics.kicad_sym | DTSM63R-V-B, SMD 6.2x6.2mm, Height 7mm, SwitchTactile, Red Cap, w/o GND Pin 260gf, Vertical, Diptronics | Switch Tactile, SPST NO, 6.2x6.2mm, h: 7.00mm, 50mA, 12VDC, 260gf (Red Cap), vertical | Switch,Button,Tactile | S | DTSM63R-V-B | SMD_Switch_Diptronics:SW_PUSH_450P620X620H700-4N_Diptronics_DTSM-63R | https://www.tme.eu/Document/f075d76e6dfb0091090699f554806dae/DTSM-6-DTE.pdf | SMD | Diptronics | DTSM63R-V-B |  |  | DTSM63R-V-B |  |  | DTSM-63R-V-B |  |  |  | 12495
Capacitor_Ceramic_THD5.00_50V_20perc_Z5U_SRPassives.kicad_sym | 1u, THD 5.00mm, 50V, 20%, Z5U, SRPassives | Capacitor ceramic MLCC, 50V, 20%, Z5U | CCAP | C | 1u/50V | THD_Capacitor_Generic:CAPRR500W50L400T250H654 | https://www.tme.eu/Document/e79cc0b1d14ccf8c64c1cdffde79c49d/CM-10.pdf | THD | SR Passives | CM-1U |  |  |  |  |  | CM-1U |  |  |  | 1670
Capacitor_Ceramic_SMD_0805_50V_10perc_X7R_Generic.kicad_sym | 15n, SMD 0805, 50V, 10%, X7R, Generic | Capacitor ceramic MLCC, 50V, 10%, X7R | CCAP | C | 15n/50V | SMD_Capacitor_NonPolarised_Generic:CAPC2012X85N_0805 |  | SMD | Generic |  |  |  |  |  |  |  |  |  |  | 39
Capacitor_Ceramic_SMD_0805_50V_10perc_X7R_Generic.kicad_sym | 1n, SMD 0805, 50V, 10%, X7R, Generic | Capacitor ceramic MLCC, 50V, 10%, X7R | CCAP | C | 1n/50V | SMD_Capacitor_NonPolarised_Generic:CAPC2012X85N_0805 |  | SMD | Generic
Capacitor_Ceramic_SMD_0805_50V_10perc_X7R_Generic.kicad_sym | 22n, SMD 0805, 50V, 10%, X7R, Generic | Capacitor ceramic MLCC, 50V, 10%, X7R | CCAP | C | 22n/50V | SMD_Capacitor_NonPolarised_Generic:CAPC2012X85N_0805 |  | SMD | Generic
Capacitor_Ceramic_SMD_0805_50V_10perc_X7R_Generic.kicad_sym | 2n2, SMD 0805, 50V, 10%, X7R, Generic | Capacitor ceramic MLCC, 50V, 10%, X7R | CCAP | C | 2n2/50V | SMD_Capacitor_NonPolarised_Generic:CAPC2012X85N_0805 |  | SMD | Generic
Capacitor_Ceramic_SMD_0805_50V_10perc_X7R_Generic.kicad_sym | 470n, SMD 0805, 50V, 10%, X7R, Generic | Capacitor ceramic MLCC, 50V, 10%, X7R | CCAP | C | 470n/50V | SMD_Capacitor_NonPolarised_Generic:CAPC2012X85N_0805 |  | SMD | Generic
Capacitor_Ceramic_SMD_0805_50V_10perc_X7R_Generic.kicad_sym | 47n, SMD 0805, 50V, 10%, X7R, Generic | Capacitor ceramic MLCC, 50V, 10%, X7R | CCAP | C | 47n/50V | SMD_Capacitor_NonPolarised_Generic:CAPC2012X85N_0805 |  | SMD | Generic
Capacitor_Ceramic_SMD_0805_50V_10perc_X7R_Generic.kicad_sym | 4n7, SMD 0805, 50V, 10%, X7R, Generic | Capacitor ceramic MLCC, 50V, 10%, X7R | CCAP | C | 4n7/50V | SMD_Capacitor_NonPolarised_Generic:CAPC2012X85N_0805 |  | SMD | Generic
Capacitor_Ceramic_SMD_0805_50V_5perc_C0G-NP0_Generic.kicad_sym | 100p, SMD 0805, 50V, 5%, C0G(NP0), Generic | Capacitor ceramic MLCC, 50V, 5%, C0G(NP0) | CCAP | C | 100p/50V | SMD_Capacitor_NonPolarised_Generic:CAPC2012X85N_0805 |  | SMD | Generic |  |  |  |  |  |  |  |  |  |  | 3061
Capacitor_Ceramic_SMD_0805_50V_5perc_C0G-NP0_Generic.kicad_sym | 220p, SMD 0805, 50V, 5%, C0G(NP0), Generic | Capacitor ceramic MLCC, 50V, 5%, C0G(NP0) | CCAP | C | 220p/50V | SMD_Capacitor_NonPolarised_Generic:CAPC2012X85N_0805 |  | SMD | Generic
Capacitor_Ceramic_SMD_0805_50V_5perc_C0G-NP0_Generic.kicad_sym | 470p, SMD 0805, 50V, 5%, C0G(NP0), Generic | Capacitor ceramic MLCC, 50V, 5%, C0G(NP0) | CCAP | C | 470p/50V | SMD_Capacitor_NonPolarised_Generic:CAPC2012X85N_0805 |  | SMD | Generic
Capacitor_Ceramic_SMD_0805_25V_10perc_X7R_Samsung.kicad_sym | 1u, SMD 0805, 25V, 10%, X7R, Samsung | Capacitor ceramic MLCC, 25V, 10%, X7R | CCAP | C | 1u/25V | SMD_Capacitor_NonPolarised_Generic:CAPC2012X125N_0805 | https://www.tme.eu/Document/4a42202b32dab16128fe107dd69598cc/samsung-chip-cap.pdf | SMD | Samsung | CL21B105KAFNNNE |  | C116352 | 187-CL21B105KAFNNNE | 766-5682 |  | CL21B105KAFNNNE | 3013481 | 1276-1066-1-ND | 118777 | 7368
Capacitor_Ceramic_SMD_0603_50V_5perc_C0G-NP0_Murata.kicad_sym | 330p, SMD 0603, 50V, 5%, C0G(NP0), Murata | Capacitor ceramic MLCC, 50V, 5%, C0G(NP0), -55 to 125â„ | CCAP | C | 330p/50V | SMD_Capacitor_NonPolarised_Generic:CAPC1608X80N_0603 | https://search.murata.co.jp/Ceramy/image/img/A01X/G101/ENG/GRM1885C1H331JA01-01A.pdf | SMD | Murata | GRM1885C1H331JA01D |  | C85978 | 81-GRM39C331J50 |  |  | GRM1885C1H331JA01D | 8819890 | 490-1439-1-ND |  | 11771
IC_Interface_Renesas.kicad_sym | ICL3232IBNZ, SOIC16, 232 Transceiver, Micropower, 250kbps, 3-5V, Renesas | RS232 Transceiver, 3-5V, 250 kbps, Ishdn: <1uA, -40 to 85Â°C | 232 | U | ICL3232IBNZ | SMD_IC_Generic:SOIC127P600X175-16N_SOIC-16 | https://eu.mouser.com/datasheet/3/1166/1/REN_icl3221_22_23_32_41_43_DST_20190405.pdf | SMD | Renesas | ICL3232IBNZ | 3232IBNZ | C1544611 | 968-ICL3232IBNZ | 921-5589 |  | ICL3232IBNZ | 2687083 | ICL3232IBNZ-ND | T1227127
Resistor_SMD_1206_0.5W_1perc_100ppm_Vishay.kicad_sym | 33R, SMD 1206, 0.5W, 1%, 100ppm | Resistor, High Powetr, SMD 1206, 0.5W, 1%, 100ppm, RCS e3 series | RES,RES1206 | R | 33R/1%/0.5W | SMD_Resistor_Generic:RESC3116X55N_1206 | https://www.vishay.com/docs/20065/rcse3.pdf | SMD | Vishay | RCS120633R2FKEA |  | C4289870 | 71-RCS120633R2FKEA |  |  |  |  | 541-10628-2-ND |  | 12679
Capacitor_Tantal_SMD_1206_10V_10perc_AVX.kicad_sym | 22u, SMD 1206, 10V, 10%, AVX | Capacitor Tantal, 10V, 10%, -55-125Â°C, TAJ Series | TCAP,CAP | C | 22u/10V | SMD_Capacitor_Polarised_Generic:CAPCP3216X170N_1206_Case-A | https://datasheets.kyocera-avx.com/TAJ.pdf | SMD | Generic | TAJA226K010RNJ | 226A | C11366 | 581-TAJA226K010R |  |  | TAJA226K010R | 1135050 | 478-1663-1-ND | 134547 | 7060
Opto_BrightLed.kicad_sym | BL-R2132N, THD, Rectange 1.9x5mm, Flat, Green, 20mA, BrightLed | LED, Rectangle 1.9x5x7mm, Green 568nm, Lens:Flat, Green Diffused, No-Flange, 6mcd@20mA, 125Â°, Vf: 2.2V@20mA | LED | D | BL-R2132N-Green | THD_Opto_BrightLed:LEDRR254W50L500T190H700-2N_FLT_NF_LL500_SH150_Green_BrightLed | https://www.flying1688.com/upload/files/BL-R2132N.pdf | THD | Bright Led Electronics | BL-R2132N |  |  |  |  |  |  |  |  |  | 10218
Audio_Multicomp.kicad_sym | ABI-009-RC, THD, 30mA, 4-8V, 85dB, Multicomp | Electromechanical element polarised, 2300Hz, 30mA, 4-8V, 85dB | BZ | Y | ABI-009-RC | THD_Audio_Multicomp:SPKADV760W60D1200H950-2N_ABI009_MULTICOMP | https://www.farnell.com/datasheets/2861429.pdf | THD | Multicomp | ABI-009-RC |  |  |  |  |  |  | 1022397
Audio_Multicomp.kicad_sym | ABT-410-RC, SMD, 15mA, 3V, 80dB, Multicomp | Electromagnetic element polarised, 2048Hz, 15mA, 1-3.0V, 80dB | BZ | Y | ABT-410-RC | THD_Audio_Multicomp:SPKADVV_650W60D1200H850-2N_ABT410_MULTICOMP | https://www.farnell.com/datasheets/2861429.pdf | THD | Multicomp | ABT-410-RC |  |  |  |  |  |  | 1022402
Capacitor_Ceramic_SMD_0603_50V_10perc_X7R_Kemet.kicad_sym | 100n, SMD 0603, 50V, 10%, X7R, Kemet | Capacitor ceramic MLCC, 50V, 10%, X7R | CCAP | C | 100n/50V | SMD_Capacitor_NonPolarised_Generic:CAPC1608X80N_0603 | https://www.mouser.sk/datasheet/2/447/KEM_C1002_X7R_SMD-3316098.pdf | SMD | Kemet | C0603C104K5RACTU |  | C127833 | 80-C0603C104K5R |  |  | C0603C104K5RAC | 1288255 | 399-C0603C104K5RACTUCT-ND
Audio_Murata.kicad_sym | PKLCS1212E4001-R1, SMD, 25V, 65dB, Murata | SMD Piezo element non polarised, 65 dB (4kHz) | BZ | Y | PKLCS1212E4001-R1 | SMD_Audio_Murata:SPK_1200X1200H300-2N_PLKCS_MURATA | https://www.farnell.com/datasheets/2157985.pdf | SMD | Murata | PKLCS1212E4001-R1 |  |  |  |  |  |  | 1192551 |  |  | 1813
Capacitor_Ceramic_SMD_1206_50V_10perc_X7R_Samsung.kicad_sym | 10n, SMD 1206, 50V, 10%, X7R, Samsung | Capacitor ceramic MLCC, 50V, 10%, X7R | CCAP | C | 10n/50V | SMD_Capacitor_NonPolarised_Generic:CAPC3216X85N_1206 | https://www.tme.eu/Document/7da762c1dbaf553c64ad9c40d3603826/mlcc_samsung.pdf | SMD | Samsung | CL31B103KBCNNNC |  | C153292 | 187-CL31B103KBCNNNC | 766-6907 |  | CL31B103KBCNNNC | 3013520 | 1276-1035-1-ND
Capacitor_Ceramic_SMD_1206_50V_10perc_X7R_Samsung.kicad_sym | 2u2, SMD 1206, 50V, 10%, X7R, Samsung | Capacitor ceramic MLCC, 50V, 10%, X7R | CCAP | C | 2u2/50V | SMD_Capacitor_NonPolarised_Generic:CAPC3216X160N_1206 | https://weblib.samsungsem.com/mlcc/mlcc-ec-data-sheet.do?partNumber=CL31B225KBHNNN | SMD | Samsung | CL31B225KBHNNNE |  | C50254 | 187-CL31B225KBHNNNE | 766-6767 |  | CL31B225KBHNNNE | 4539046 | 1276-1291-1-ND | 104630 | 7068
Capacitor_Ceramic_SMD_0603_50V_10perc_X7R_Samsung.kicad_sym | 100n, SMD 0603, 50V, 10%, X7R, Samsung | Capacitor ceramic MLCC, 50V, 10%, X7R | CCAP | C | 100n/50V | SMD_Capacitor_NonPolarised_Generic:CAPC1608X80N_0603 | https://media.digikey.com/pdf/Data%20Sheets/Samsung%20PDFs/CL10B104KB8NNNC_Spec.pdf | SMD | Samsung | CL10B104KB8NNNC |  | C1591 |  |  |  |  |  | 1276-1000-1-ND |  | 7016
Capacitor_Ceramic_SMD_0603_50V_10perc_X7R_Samsung.kicad_sym | 10n, SMD 0603, 50V, 10%, X7R, Samsung | Capacitor ceramic MLCC, 50V, 10%, X7R, -55 to 125â„ | CCAP | C | 10n/50V | SMD_Capacitor_NonPolarised_Generic:CAPC1608X80N_0603 | https://media.digikey.com/pdf/Data%20Sheets/Samsung%20PDFs/CL10B104KB8NNNC_Spec.pdf | SMD | Samsung | CL10B103KB8NNNC |  | C1589 | 187-CL10B103KB8NNNC | 766-5373 |  | CL10B103KB8NNNC | 3013408 | 1276-1009-1-ND |  | 4864
Capacitor_Ceramic_SMD_0603_50V_10perc_X7R_Samsung.kicad_sym | 22n, SMD 0603, 50V, 10%, X7R, Samsung | Capacitor ceramic MLCC, 50V, 10%, X7R | CCAP | C | 22n/50V | SMD_Capacitor_NonPolarised_Generic:CAPC1608X80N_0603 | https://www.tme.eu/Document/4a42202b32dab16128fe107dd69598cc/samsung-chip-cap.pdf | SMD | Samsung | CL10B223KB8NNNC |  | C21122 | 187-CL10B223KB8NNNC | 766-5402 |  | CL10B223KB8NNNC | 3013425 | 1276-1104-1-ND |  | 5461
Capacitor_Ceramic_SMD_0603_50V_10perc_X7R_Samsung.kicad_sym | 6n8, SMD 0603, 50V, 10%, X7R, Samsung | Capacitor ceramic MLCC, 50V, 10%, X7R | CCAP | C | 6n8/50V | SMD_Capacitor_NonPolarised_Generic:CAPC1608X80N_0603 | https://www.tme.eu/Document/4a42202b32dab16128fe107dd69598cc/samsung-chip-cap.pdf | SMD | Samsung | CL10B682KB8NNNC |  | C84723 | 187-CL10B682KB8NNNC |  |  | CL10B682KB8NNNC |  | 1276-1185-1-ND |  | 7114
Connector_DC_Ninigi.kicad_sym | 4840.2202, THD, DC Power Barrel Jack, 5.7x2.0mm, PCB, Horizontal, Schurter | DC Power Barrel Jack, Male, 5.7x2.0mm, 0.5A, 12VDC, PCB, Horizontal | DC | X | 4840.2202 | THD_Connector_DC_Schurter:CONNDCJACK_3N_4840.2202_SCHURTER | https://www.tme.eu/Document/78afd4fb8a41e4211137cd818ea9e93d/PC-GK21.jpg | THD | Schurter | 4840.2202 |  | C3095939 | 693-4840.2202 | 269-3835 |  | 4840.2202 |  | 486-4186-ND | 249344
Connector_DC_Ninigi.kicad_sym | PC-GK2.1, THD, DC Power Barrel Jack, 5.5x2.1mm, PCB, Horizontal, Ninigi | DC Power Barrel Jack, Male, 5.5x2.1mm, PCB, Horizontal | DC | X | PC-GK2.1 | THD_Connector_DC_Ninigi:CONNDCJACK_3N_PC-GK2.1_NINIGI | https://www.tme.eu/Document/78afd4fb8a41e4211137cd818ea9e93d/PC-GK21.jpg | THD | Ninigi | PC-GK2.1 |  |  |  |  |  | PC-GK2.1 |  |  |  | 7188
Diode_Diotec.kicad_sym | 1N4148, DO35, Signal diode, 100V, 200mA, Diotec | Diode Small Signal, Vrrm: 100V, If: 200mA, Ir<25nA, Vf<1.0V @10mA | D | D | 1N4148 | THD_Diode_Generic:DIOAD762W50L390D190N_DO-35 | https://www.tme.eu/Document/c6f6445616a0da67965224a113dd79b5/1n4148.pdf | THD | Diotec Semiconductor | 1N4148 |  |  | 1N4148 |  | 170-00-557 | 1N4148-DIO |  | 4878-1N4148CT-ND | 14088 | 254
Diode_Diotec.kicad_sym | BAS70-06, SOT23, Schottky dual diode CA, 70V, 70mA, Diotec | Diode Schottky Dual Common Anode, Vrrm: 70V, If: 70mA, Ir=100nA, Vf=1.0V @15mA | D | D | BAS70-06 | SMD_Semiconductor_Generic:SOT95P250X110-3N_SOT23-3 | https://www.tme.eu/Document/c7f77dfcc13a1a9c9abcb29db7308aba/bas70.pdf | SMD | Diotec Semiconductor | BAS70-06 | 76 |  |  |  |  | BAS70-06-DIO |  |  |  | 11604
Diode_Diotec.kicad_sym | BAT54A, SOT23, Schottky dual diode CA, 30V, 200mA, Diotec | Diode Schottky Dual Common Anode, Vrrm: 30V, If: 200mA, Ir=200nA, Vf=0.4V @10mA | D | D | BAT54A | SMD_Semiconductor_Generic:SOT95P250X110-3N_SOT23-3 | https://www.tme.eu/Document/ff17162de6a4eb9b82714a611797118f/bat54.pdf | SMD | Diotec Semiconductor | BAT54A | L42 |  |  |  |  | BAT54A-DIO
Diode_Diotec.kicad_sym | BAT54C, SOT23, Schottky dual diode, CC, 30V, 200mA, Diotec | Diode Schottky Dual Common Cathode, Vrrm: 30V, If: 200mA, Ir=200nA, Vf=0.4V @10mA | D | D | BAT54C | SMD_Semiconductor_Generic:SOT95P250X110-3N_SOT23-3 | https://www.tme.eu/Document/ff17162de6a4eb9b82714a611797118f/bat54.pdf | SMD | Diotec Semiconductor | BAT54C | L43 |  |  |  |  | BAT54C-DIO |  |  |  | 5487
Diode_Diotec.kicad_sym | SGL1-100, DO213AC, Schottky diode, 100V, 1A, Diotec | Diode Schottky, Vrrm: 100V, If: 1A, Ir<1mA, Vf<0.82V | D | D | SGL1-100 | SMD_Semiconductor_Generic:DIOMELF3414N_DO213AC_MiniMELF | https://www.tme.eu/Document/0905986325995d0335e211cc3d6db030/sgl1.pdf | SMD | Diotec Semiconductor | SGL1-100 |  | C3757862 | C3757862 |  |  | SGL1-100-DIO |  | 4878-SGL1-100-ND | 61216 | 5340
Diode_Diotec.kicad_sym | SK110, DO214AA, Schottky diode, 100V, 1A, Diotec | Diode Schottky, Vrrm: 100V, If: 1A, Ir<2mA, Vf<0.85V @1A | D | D | SK110 | SMD_Semiconductor_Generic:DIOM5027X210N_DO214AC_SMA | https://diotec.com/request/datasheet/sk12.pdf | SMD | Diotec Semiconductor | SK110 | SK110 | C18213536 | 637-SK110 |  |  | SK110-DIO |  | 4878-SK110CT-ND | 61221 | 2882
Diode_Diotec.kicad_sym | SK25, DO214AA, Schottky diode, 50V, 2A, Diotec | Diode Schottky, Vrrm: 50V, If: 2A, Ir<500uA, Vf<0.7V @2A | D | D | SK25 | SMD_Semiconductor_Generic:DIOM5539X261N_DO214AA_SMB-J | https://www.tme.eu/Document/3679d5d170502be32d192cd5d52751ab/sk22.pdf | SMD | Diotec Semiconductor | SK25 | SK25 |  | 637-SK25 |  |  | SK25-DIO |  | 4878-SK25-ND | 50909
Diode_Diotec.kicad_sym | SK26, DO214AA, Schottky diode, 60V, 2A, Diotec | Diode Schottky, Vrrm: 60V, If: 2A, Ir<500uA, Vf<0.7V @2A | D | D | SK26 | SMD_Semiconductor_Generic:DIOM5539X261N_DO214AA_SMB-J | https://www.tme.eu/Document/3679d5d170502be32d192cd5d52751ab/sk22.pdf | SMD | Diotec Semiconductor | SK26 | SK26 |  | 637-SK26 |  |  | SK26-DIO |  | 4878-SK26CT-ND | 65457 | 2883
Diode_Diotec.kicad_sym | SK35, DO214AB, Schottky diode, 50V, 3A, Diotec | Diode Schottky, Vrrm: 50V, If: 3A, Ir<8uA, Vf<0.75V @3A | D | D | SK35 | SMD_Semiconductor_Generic:DIOM7959X290N_DO214AB_SMC | https://diotec.com/request/datasheet/sk32.pdf | SMD | Diotec Semiconductor | SK35 | SK35 |  | 637-SK35 |  |  | SK35-DIO |  | 4878-SK35CT-ND | 296742
Diode_Diotec.kicad_sym | SL1G, SOD123FL, Std. recovery diode, 400V, 1A, Diotec | Diode Std. Recovery, Vrrm: 400V, If: 1A, Ir<1uA, Vf<1.1V @1A | D | D | SL1G | SMD_Semiconductor_Generic:SOD3718X130N_SOD-123FL | https://diotec.com/request/datasheet/sk12.pdf | SMD | Diotec Semiconductor | SL1G |  | C17318040 | 637-SL1G |  |  | SL1G-DIO |  | 4878-SL1GCT-ND | 296776 | 3678
Diode_Diotec.kicad_sym | SM5817, DO213AB, Schottky diode, 20V, 1A, Diotec | Diode Schottky, Vrrm: 20V, If: 1A, Ir<1mA, Vf<0.75V @3A | D | D | SM5817 | SMD_Semiconductor_Generic:DIOMELF5025N_DO213AB_MELF | https://www.tme.eu/Document/3679d5d170502be32d192cd5d52751ab/sk22.pdf | SMD | Diotec Semiconductor | SM5817 |  | C3757555 | 637-SM5817 |  |  | SM5817-DIO |  | 4878-SM5817-ND | 296797
Diode_Diotec.kicad_sym | SM5818, DO213AB, Schottky diode, 30V, 1A, Diotec | Diode Schottky, Vrrm: 30V, If: 1A, Ir<1mA, Vf<0.875V @3A | D | D | SM5818 | SMD_Semiconductor_Generic:DIOMELF5025N_DO213AB_MELF | https://www.tme.eu/Document/3679d5d170502be32d192cd5d52751ab/sk22.pdf | SMD | Diotec Semiconductor | SM5818 |  | C3758086 | 637-SM5818 |  |  | SM5818-DIO |  | 4878-SM5818CT-ND | 296798
Diode_Diotec.kicad_sym | SM5819, DO213AB, Schottky diode, 40V, 1A, Diotec | Diode Schottky, Vrrm: 40V, If: 1A, Ir<1mA, Vf<0.9V @3A | D | D | SM5819 | SMD_Semiconductor_Generic:DIOMELF5025N_DO213AB_MELF | https://diotec.com/request/datasheet/sm5817.pdf | SMD | Diotec Semiconductor | SM5819 |  | C3758931 | 637-SM5819 |  |  | SM5819-DIO |  | 4878-SM5819CT-ND | 50338 | 10106
Diode_Diotec.kicad_sym | SMS290, DO213AB, Schottky diode, 90V, 2A, Diotec | Diode Schottky, Vrrm: 90V, If: 2A, Ir<500uA, Vf<0.79V @2A | D | D | SMS290 | SMD_Semiconductor_Generic:DIOMELF5025N_DO213AB_MELF | https://www.tme.eu/Document/c249acbb221bab9532f1d9f2b3d79a8b/sms220.pdf | SMD | Diotec Semiconductor | SMS290 |  | C3758483 | 637-SMS290 |  | 302-53-931 | SMS290-DIO |  | 2721-SMS290TR-ND | 125039 | 1139
Diode_Diotec.kicad_sym | SZ3C6.2, DO213AB, Zener diode, 6.2V, 455mA, Diotec | Diode Zener, 6.2V, 455mA, 3W | D | D | SZ3C6.2 | SMD_Semiconductor_Generic:DIOMELF5025N_DO213AB_MELF | https://www.tme.eu/Document/36c8b773f98b676ed2bf112c2b958cda/sz3c1.pdf | SMD | Diotec | SZ3C6.2 |  | C3737858 | 637-SZ3C6.2 |  |  | SZ3C6.2-DIO | 4730080 | 4878-SZ3C6.2CT-ND | 129755 | 11784
EMI-EMC_Module_Schaffner.kicad_sym | FN 402-1.6-02, THD, 1.6A, 230VAC, RM 10.0mm, Body{colon}45x28x16.5, Schaffner | EMC Filter, 230VAC, 1.6A | EMI,EMC | A | FN 402-1.6-02 | THD_Filter_Schaffner:DIP3300W60P100L4500H1650Q5_Schaffner | https://www.farnell.com/datasheets/2189000.pdf | THD | Schaffner | FN 402-1.6-02 |  |  | 631-FN402-1.6-02 | 217-0763 | 169-66-030 | FN402-1.6-02 | 1191325 | 817-1183-ND
FuseHolder_Stelvio.kicad_sym | PTF/78, THD, Fuse holder, 5x20, Stelvio | Fuse holder 5x20mm | FH | ME | PTF/78 | THD_FuseHolder_Stelvio:PTF-78+BS232 | https://www.tme.eu/Document/3b48dbe2b9714a62652c97b08fcd464b/PTF78.pdf | THD | Stelvio Kontek | PTF/78 |  |  |  |  |  | ZHL78 |  |  |  | 3513
GDT_Bourns.kicad_sym | 2030-23T-SM-RPLF, SMD, Gas disch. tube, 185V, 4kA, Bourns | Gas Discharge Tube, Fast, 185V, 4kA, -40 to 90Â°C | GDT | Z | 2030-23T-SM-RPLF | SMD_GDT_Bourns:2030-xxT-SM_BOURNS | https://www.bourns.com/docs/product-datasheets/2030-xxt-sm.pdf | SMD | Bourns | 2030-23T-SM-RPLF |  | C3659692 | 652-2030-23T-SM-RPLF | 233-0723 | 302-38-521 |  | 2118248 | 118-2030-23T-SM-RPLFCT-ND |  | 12729
Header_Generic.kicad_sym | HEAD_10_PIN, 2x5pin, 2.54mm, Locker, Male | Header | CON10 | X | HEAD_10_PIN | THD_Connector_IDC_Generic:HDRV10W64P254H2800_2X5_LongLatches-DIN41651 |  |  | Generic
Header_Generic.kicad_sym | HEAD_20_PIN, 2x10pin, 2.54mm, PCB Only | Header | CON20 | X | HEAD_20_PIN |  |  | THD | Generic
Header_Generic.kicad_sym | HEAD_8_PIN, 1x8pin, 2.54mm, PCB Only | Header | CON | X | HEAD_8_PIN | THD_Header_Generic:HDRV8W64P254H0_1X8_PADRR_140x240_FEMALE |  |  | Generic
IC_Analog_TI.kicad_sym | CD74HC4066M96, SOIC14, 4-Channel Analog Switch, 1{gt}1SPST, 2-20V, TI | 4-Channel Analog Switch, 1:1 SPST, 0-10V Analog, 2-10V, -55 to 125Â°C | IC | U | CD74HC4066M96 | SMD_IC_TI:SOIC127P600X175-14N_SO-14_TI | https://www.ti.com/lit/ds/symlink/cd74hc4066.pdf | SMD | Texas Instruments | CD74HC4066M96 |  | C179842 | 595-CD74HC4066M96 | 178-8944 |  | CD74HC4066M96 | 3005431 | 296-9224-1-ND
IC_Analog_TI.kicad_sym | INA139NA, SOT23-5, HS Current shunt monitor, 2.7-40V, TI | High-Side Measurement Current Shunt Monitor, 2.7-40V | IC | U | INA139 | SMD_IC_Generic:SOT95P280X145-5N_SOT23-5__12345 | https://www.ti.com/lit/ds/symlink/ina139.pdf | SMD | Texas Instruments | INA139NA | E39 | C129947 | 595-INA139NA/3K | 461-6558 |  | INA139NA/250 | 3118123 | 296-26061-1-ND
IC_Analog_TI.kicad_sym | LM358ADR, SO8, Dual 2-input OpAmp, 3-36V, TI | Dual 2â€“Input OpAmp, 3-36V, 1.2MHz, 0 to 70 Â°C | opamp | U | LM358ADR | SMD_IC_Generic:SOIC127P600X175-8N_SO-8_MS-012 | https://www.ti.com/lit/ds/symlink/lm358a.pdf | SMD | Texas Instruments | LM358ADR | LM358A | C74525 | 595-LM358ADR | 526-262 |  | LM358ADR |  | 296-14601-1-ND |  | 9577
IC_Analog_TI.kicad_sym | NE555P, THD, Precision timer, 4.5-16V, TI | Precision Timer, TTL, 4.5-16V | IC | U | NE555P | THD_IC_Generic:DIP-8_W7.62mm | https://www.ti.com/lit/gpn/ne555 | THD | Texas Instruments | NE555P |  | C46749 | 595-NE555P | 221-5535 | 173-04-265 | NE555P | 3006909 | 296-NE555P-ND | 17814 | 591
IC_Analog_TI.kicad_sym | OPA2990IDSGR, WSON8, Dual 2-input OpAmp, R-to-R, 2.7-40V, TI | Dual 2â€“Input OpAmp, Rail-to-Rail, 2.7-40V | opamp | U | OPA2990IDSGR | SMD_IC_Generic:SON50P200X200X80-9N_WSON-8 | https://www.ti.com/lit/ds/symlink/opa2990.pdf | SMD | TI | OPA2990IDSGR | O29G | C2057874 | 595-OPA2990IDSGR |  |  | OPA2990IDSGR |  | 296-OPA2990IDSGRCT-ND
IC_Analog_TI.kicad_sym | TL074CDR, SOIC14, Dual 2-input OpAmp, JFET, 4.5-40V, TI | Quad 2â€“Input OpAmp, LowNoise, JFET, 4.5-40V, 0 to 70 Â°C | opamp | U | TL074CDR | SMD_IC_TI:SOIC127P600X175-14N_SO-14_TI | https://www.farnell.com/datasheets/1861173.pdf | SMD | Texas Instruments | TL074CDR | TL074C | C12594 | 595-TL074CDR |  |  | TL074CDR | 3005123 | 296-1283-1-ND |  | 2755
IC_Analog_TI.kicad_sym | TLV3201AQDCKRQ1, SC70, 2-input Comp, PP, 2.7-5.0V, TI | 2â€“Input, 40-ns, Micropower, Push-Pull Output Automotive Comparators, 2.7-5.0V, -40 to 125 Â°C | comparator | U | TLV3201AQDCKRQ1 | SMD_Semiconductor_Generic:SOT65P200X125-5N_SC70 | https://www.ti.com/lit/ds/symlink/tlv3201-q1.pdf | SMD | Texas Instruments | TLV3201AQDCKRQ1 | 5HF | C3658542 | 595-TLV3201AQDCKRQ1 |  |  | TLV3201AQDCKRQ1 |  | 296-46596-1-ND |  | 11525
IC_Analog_TI.kicad_sym | TMUX11001, SOT23-5, Precicion switch, 1{gt}1 SPST, 1.08-5.5V, TI | Precision switch, low-leakage-current, 1:1 SPST, 1.08-5.5V | IC | U | TMUX11001 | SMD_IC_Generic:SOT95P280X145-5N_SOT23-5__12345 | https://www.ti.com/lit/ds/symlink/tmux1102.pdf?HQS=dis-mous-null-mousermode-dsf-pf-null-wwe&ts=1695627192365 | SMD | Texas Instruments |  | 1W1F |  | 595-TMUX1101DBVR |  |  |  |  | 296-TMUX1101DBVRCT-ND
IC_Analog_TI.kicad_sym | TS5A23159, VSSOP10, Analog switch, 2Ch, SPDT, 5V/3V, TI | Analog switch Bidirectional, 1 Ohm, Switching: 1.65-5.5V, 2:1 SPDT, VCC: 1.65-5.5V | IC | U | TS5A23159 | SMD_IC_Generic:SOP50P500X110-10N_VSSOP-10 | https://www.ti.com/lit/ds/symlink/ts5a23159.pdf | SMD | Texas Instruments | TS5A23159DGSR | JEQ, JER | C42751 | 595-TS5A23159DGSR |  |  | TS5A23159DGSR | 3005459 | 296-18598-1-ND
IC_Logic_Nexperia.kicad_sym | 74AHC08D, SO14, 4x 2-Input AND, 2.0-5.5V, O{colon}25mA, Nexperia | Quad 2â€“Input And gate, High-speed, 2.0...5.5V, Out:+/-25mA, -40...+125 Â°C | AND | U | 74AHC08D | SMD_IC_Nexperia:SOIC127P600X175-14N_SO-14_Nexperia | https://assets.nexperia.com/documents/data-sheet/74AHC_AHCT08.pdf | SMD | Nexperia | 74AHC08D,118 |  | C5506 | 771-AHC08D118 | 182-1902 |  | 74AHC08D.118 | 2438528 | 1727-5915-1-ND | T1095986
IC_Logic_Nexperia.kicad_sym | 74HCT08D, SO14, 4x 2-Input AND, 4.5-5.5V, Nexperia | Quad 2â€“Input And gate, High-speed, 4.5...5.5V, -40...+125 Â°C | AND | U | 74HCT08D | SMD_IC_Nexperia:SOIC127P600X175-14N_SO-14_Nexperia | https://www.tme.eu/Document/0d71b21dae086a3e7b4608ad17ed3b20/74HCT08D,653.pdf | SMD | Nexperia | 74HCT08D,653 |  | C5959 | 771-74HCT08D-T | 219-4276 |  | 74HCT08D.653 | 1085301 | 1727-2831-1-ND | T1200074
IC_Logic_TI.kicad_sym | 74AHC08D, SO14, 4x 2-Input AND, 2.0-5.5V, O{colon}25mA, TI | Quad 2â€“Input And gate, High-speed, 2.0...5.5V, Out:+/-25mA, -40...+125 Â°C | AND | U | SN74AHC08DR | SMD_IC_TI:SOIC127P600X175-14N_SO-14_TI | https://www.ti.com/lit/ds/symlink/sn74ahc08.pdf?ts=1723157451898 | SMD | Texas Instruments | SN74AHC08DR |  | C6937 | 595-SN74AHC08DR |  |  | SN74AHC08DR | 3120291 | 296-4523-1-ND
IC_Logic_TI.kicad_sym | SN74AHC1G00DBV, SOT23-5, Single 2-Input NAND, 2.0-5.5V, TI | Single 2â€“Input NAN Gate, 2.0-5.5V |  | U | 74AHC1G00 | SMD_IC_Generic:SOT95P280X145-5N_SOT23-5__12345 | http://www.ti.com/lit/ds/symlink/sn74ahc1g00.pdf | SMD | TI | SN74AHC1G00DBV |  |  | 595-SN74AHC1G00DBVR |  | 666829 |  | 1105915 |  | W009788 | 9022
IC_Power_Infineon.kicad_sym | TLS810A1LDV33XUMA1, TSON10, LDO reg, 3.3V, 100mA, Infineon | LDO Regulator, Vo: 3.3V, Iq: 5.0ÎĽA, Vi:max 42V, Io: 100mA | IC | U | TLS810A1LDV33 | SMD_IC_Infineon:SOP50P330X100-10N_PG-TSON-10_Infineon | https://www.infineon.com/assets/row/public/documents/10/49/infineon-tls810a1ld-v33-datasheet-en.pdf | SMD | Infineon | TLS810A1LDV33XUMA1 | 810A1V3 | C3751361 | 726-TLS810A1LDV33XUM | 258-1686 |  |  | 3267656 | TLS810A1LDV33XUMA1CT-ND | T554020 | 1966
IC_Power_Infineon.kicad_sym | TLS810B1LDV33XUMA1, TSON10, LDO reg, 3.3V, 100mA, Infineon | LDO Regulator, Vo: 3.3V, Iq: 5.5ÎĽA, Vi:max 42V, Io: 100mA, with Enable | IC | U | TLS810B1LDV33XUMA1 | SMD_IC_Infineon:SOP50P330X100-10N_PG-TSON-10_Infineon | https://www.farnell.com/datasheets/2354841.pdf | SMD | Infineon | TLS810B1LDV33XUMA1 | 810B1V3 | C3750147 | 726-TLS810B1LDV33XUM | 258-1686 |  |  | 2780918 | TLS810B1LDV33XUMA1CT-ND
IC_Power_TI.kicad_sym | LM22674MR-ADJ/NOPB, HSOP8, Switching Volt Reg, Adj, 3A, TI | Switching Voltage Regulators, Vo: Adj, Fb:1.28V, Iq: 6mA, Vi: 4.5-42V, Io: 3A, 500kHz, -40 to 125Â°C, With Enable | IC | U | LM22674MR-ADJ/NOPB | SMD_IC_Generic:SOP127P600X175-9N_HSOP-8 | https://www.ti.com/lit/ds/symlink/lm22674.pdf?ts=1727363970936 | SMD | Texas Instruments | LM22674MR-ADJ/NOPB | L22674 ADJ |  | 926-LM22674MRADJNOPB | 121-9048 |  |  |  | LM22674MR-ADJ/NOPB-ND
IC_Power_TI.kicad_sym | LM22675MRE-ADJ/NOPB, HSOP8, Switching Volt Reg, Adj, 1A, TI | Switching Voltage Regulators, Vo: Adj, Fb:5.0V, Iq: 6mA, Vi: 4.5-42V, Io: 1A, 500kHz, -40 to 125Â°C, With Enable | IC | U | LM22675MRE-ADJ | SMD_IC_Generic:SOP127P600X175-9N_HSOP-8 | https://www.ti.com/general/docs/suppproductinfo.tsp?distId=10 | SMD | Texas Instruments | LM22675MRE-ADJ/NOPB |  | C2070735 | 926-M22675MREADJNOPB | 660-6095 |  | LM22675MRE-ADJ | 2435846 | LM22675MRE-ADJ/NOPBCT-ND
IC_Power_TI.kicad_sym | LM2576HVS-12, TO263, Switching Volt Reg, 12V, 3A, TI | Switching Voltage Regulators, Vo: 12V, Fb:1.23V, Iq: 10mA, Vi: max63V, Io: 3A, Pd: 2.25W, 52kHz, -40 to 125Â°C, With OnOff | IC | U | LM2576HVS-12 | SMD_IC_Generic:TO170P1435X465-6N_D2PAK_TO-263BA_TS5B_TI | https://www.ti.com/lit/ds/symlink/lm2576.pdf | SMD | Texas Instruments | LM2576HVS-12/NOPB | LM2576 HVS-12 P+ | C143960 | 926-LM2576HVS-12NOPB |  |  | LM2576HVSX-12/NOPB | 3122855 | LM2576HVS-12/NOPB-ND
IC_Power_TI.kicad_sym | LM27313XMF/NOPB, SOT23-5, Boost Volt Reg, Vout up to 30V, 800mA, TI | Boost Voltage Regulators, Vo: max30V, Fb:1.23V, Iq: 1ÂµA, Vi: 2.7-14V, Io: 800mA, 1.6MHz, -40 to 125Â°C, With Shutdown | IC | U | LM27313 | SMD_IC_Generic:SOT95P280X145-5N_SOT23-5__12345 | https://www.ti.com/lit/ds/symlink/lm27313.pdf | SMD | Texas Instruments | LM27313XMF/NOPB | SRPB | C32355 | 926-LM27313XMF/NOPB | 761-5567 |  | LM27313XMF/NOPB | 3121546 | LM27313XMF/NOPBCT-ND |  | 12794
IC_Power_TI.kicad_sym | TLV70233DBVR, SOT23-5, LDO reg, 3.3V, 860mA, TI | LDO Regulator, Vo: 3.3V, Drop: 375mV, Iq: 35ÎĽA, Vi: max5.5V, Io: 860mA, Pd: 2.25W, -40 to 125Â°C, With Enable | IC | U | TLV70233 | SMD_Semiconductor_Generic:SOT95P280X145-5N_SOT23-5__12345 | https://www.lcsc.com/datasheet/lcsc_datasheet_1809251716_Texas-Instruments-TLV70233DBVR_C26833.pdf | SMD | Texas Instruments | TLV70233DBVR | QVD | C26833 | 595-TLV70233DBVR | 218-4659 |  | TLV70233DBVR | 3007784 | 296-32415-1-ND |  | 9426
IC_Power_TI.kicad_sym | TPS60401DBVR, SOT23-5, Voltage Inverter, Unregulated, 1.6-5.5V, 60mA, TI | LDO Regulator, Vo: 1.6-5.5V, Iq: 65ÎĽA, Vi: 1.6-5.5V, Io: 60mA, 20kHz, -40 to 125Â°C | IC | U | TPS60401DBVR | SMD_IC_Generic:SOT95P280X145-5N_SOT23-5__12345 | https://www.ti.com/lit/ds/symlink/tps60401.pdf?ts=1759418022482 | SMD | Texas Instruments | TPS60401DBVR | PFLI | C29006 | 595-TPS60401DBVR |  |  | TPS60401DBVR-TEX-0 |  | 296-37679-1-ND |  | 12862
Inductor_Epcos.kicad_sym | B82790S0513N201, SMD 9x6.0x5.2, 51uH, 500mA, 140mOhm, Epcos | Data/Signal line coil choke, Common mode, 51uH, 500mA, Rdc: 140mÎ©, Body: 7.1x6.0x5.2mm | EMI,EMC,Coil | L | B82790S0513N201 | SMD_Coil_Epcos:FLT_B82790S0_Common_Mode_Choke_EPCOS | https://www.tdk-electronics.tdk.com/inf/30/db/ind_2008/b82790c0_s0.pdf | SMD | Epcos/TDK | B82790S0513N201 |  | C404025 | 871-B82790S513N201 |  | 302-03-621 | B82790S0513N201 | 9752250 | 495-1868-1-ND | 87879
Opto_Liteon.kicad_sym | LTL-4221N, THD, Round 3mm, Convex, HE Red, 10mA, Liteon | LED, Round 3mm, High Efficiency Red 623nm, Lens:Convex,Red Diffused, Flange-Round, 8.7mcd@10mA, 60Â°, Vf:2.0V@20mA | LED | D | LTL-4221N-Red | THD_Opto_Liteon:LEDRD254W50D300H445-2N_CVX_FR_LL500_SH110_Red_Liteon | https://mm.digikey.com/Volume0/opasdata/d220001/medias/docus/1103/LTL-4221N.pdf | THD | Liteon | LTL-4221N |  |  |  |  |  | LTL-4221N |  |  |  | 5887
Opto_Liteon.kicad_sym | LTL1BETBEFJALC, THD, Dual, Round 3mm, Convex, Red/Blue, 5mA, Liteon | LED, Dual, Round 3mm, Red 624nm/Blue 471nm, Lens:Convex,White Diffused, Flange-D, 495/110mcd@5mA, 45Â°, Vf:1.9/2.8V@5mA | LED | D | LTL1BETBEFJALC-Red+Blue | THD_Opto_Liteon:LEDRD254W50D300H515-3N_CVX_FD_LL500_SH155_White_Liteon | https://www.tme.eu/Document/6011edae0651de0373e7d3ae5493e03a/LTL1BETBEFJALC-DTE.pdf | THD | Liteon | LTL1BETBEFJALC |  |  |  |  |  | LTL1BETBEFJALC |  |  |  | 9632
Opto_Liteon.kicad_sym | LTL1CHVRTNN, THD, Round 3mm, Convex,Super Red, 20mA, Liteon | LED, Round 3mm, Super Red 631nm, Lens:Convex,Red Transparent, Flange-Round, 2350mcd@20mA, 45Â°, Vf:2.0V@20mA | LED | D | LTL1CHVRTNN-Red | THD_Opto_Liteon:LEDRD254W50D310H520-2N_CVX_FR_LL500_SH100_White_Liteon | https://www.tme.eu/Document/cf281ef71e54e28ab8c7cfcc23ba4265/LTL1CHVRTNN.pdf | THD | Liteon | LTL1CHVRTNN |  |  | 859-LTL1CHVRTNN |  |  | LTL1CHVRTNN |  |  |  | 9738
Opto_Liteon.kicad_sym | LTL2R3KG, THD, Round 5mm, Convex, Green, 20mA, Liteon | LED, Round 5mm, Green 572nm, Lens:Convex,Green Diffused, Flange-D, 180mcd@20mA, 40Â°, Vf:2.1V@20mA | LED | D | LTL2R3KG-Green | THD_Opto_Liteon:LEDRD254W50D500H870-2N_CVX_FD_LL500_SH100_Green_Liteon | https://optoelectronics.liteon.com/upload/download/DS20-2000-047/LTL2R3KG.pdf | THD | Liteon | LTL2R3KG |  | C7297311 | 859-LTL2R3KG |  |  | LTL2R3KG |  | 160-1684-ND | 163345 | 795
Opto_Liteon.kicad_sym | LTL2R3KRK, THD, Round 5mm, Convex,Super Red, 20mA, Liteon | LED, Round 5mm, Super Red 631nm, Lens:Convex,Water Clear, Flange-D, 680mcd@20mA, 30Â°, Vf:2.0V@20mA | LED | D | LTL2R3KRK-Red | THD_Opto_Liteon:LEDRD254W50D500H870-2N_CVX_FD_LL500_SH100_White_Liteon | https://optoelectronics.liteon.com/upload/download/DS-20-98-0066/LTL2R3KRK.pdf | THD | Liteon | LTL2R3KRK |  | C6291023 | 859-LTL2R3KRK |  |  | LTL2R3KRK |  | 160-1685-ND | 163345 | 1723
Opto_Liteon.kicad_sym | LTST-C190KFKT, SMD 0603, Orange, 20mA, Liteon | LED, Orange, Rectangle, 1.6x0.8mm, 90mcd, 130Â°, Water Clear Front, 20mA, Vf: 2.0V | LED | D | LTST-C190KFKT | SMD_LED_Generic:LEDC1608X110-2N_0603_Orange | https://www.mouser.sk/datasheet/2/239/LTST_C190KFKT-1141312.pdf | SMD | LiteOn | LTST-C190KFKT |  | C157740 | 859-LTST-C190KFKT | 692-0979 |  | LTST-C190KFKT |  | 160-1434-1-ND |  | 2885 |  | 3D model isn't appropriate!
Opto_Liteon.kicad_sym | LTST-C193KRKT-5A, SMD 0603, Red, 5mA, Liteon | LED, Red, Rectangle, 1.6x0.8mm, 45mcd, 130Â°, Water Clear Front, 5mA, Vf: 2.3V | LED | D | LTST-C193KRKT-5A | SMD_LED_Generic:LEDC1608X110-2N_0603_Red | https://optoelectronics.liteon.com/upload/download/DS22-2005-077/LTST-C193KRKT-5A.PDF | SMD | LiteOn | LTST-C193KRKT-5A |  | C157741 | 859-LTSTC193KRKT5A | 692-1041 |  | LTST-C193KRKT-5A |  | 160-1830-1-ND |  | 10699 |  | 3D model isn't appropriate!
Opto_Liteon.kicad_sym | LTV-814S-TA1, SMD FIP4-GW, AC Optocoupler, 5kV, Liteon | Transistor AC optocoupler, 5kV, FIP-4 GullWing, CTR 20-300% |  | U | LTV-814S-TA1 | SMD_IC_Generic:DIP254P1016X450-4N-GULLWING | https://optoelectronics.liteon.com/upload/download/DS-70-96-0013/LTV-8X4%20series%20201509.pdf | SMD | Liteon | LTV-814S-TA1 |  |  |  |  |  | LTV-814S-TA1 |  |  |  | 11107
Opto_Liteon.kicad_sym | LTW-C193TS5, SMD 0603, Blue, 5mA, Liteon | LED, Blue, Rectangle, 1.6x0.8mm, 100mcd, 130Â°, Yellow Front, 5mA, Vf: 3.15V | LED | D | LTW-C193TS5 | SMD_LED_Generic:LEDC1608X110-2N_0603_Blue | https://www.mouser.sk/datasheet/2/239/Lite-On-LTW-C193TS5-1175447.pdf | SMD | LiteOn | LTW-C193TS5 |  |  |  |  |  |  |  | 160-1721-1-ND |  | 10697 |  | 3D model isn't appropriate!
Opto_Lumex.kicad_sym | SSL-LX2573GD, THD, Rectangle 2x5mm, Flat, Green, 20mA, Lumex | LED, Rectangle 2x5x7mm, Green 565nm, Lens:Flat Green Diffused, No-Flange, 10mcd@20mA,110Â°, Vf:2.2@20mA | LED | D | SSL-LX2573GD | THD_Opto_Lumex:LEDRR254W50L500T200H700-2N_FLT_NF_LL500_SH100_Green_Lumex | https://www.tme.eu/Document/54494f5ad70b21ec7439207b380571ed/SSL-LX2573GD.pdf | THD | Lumex | SSL-LX2573GD |  |  |  |  |  | SSL-LX2573GD | 8007482
Opto_Lumex.kicad_sym | SSL-LX2573SRD, THD, Rectangle 2x5mm, Flat, Red, 20mA, Lumex | LED, Rectangle 2x5x7mm, Red 660nm, Lens:Flat Red Diffused, No-Flange, 80mcd@20mA, 110Â°, Vf:1.7@20mA | LED | D | SSL-LX2573SRD | THD_Opto_Lumex:LEDRR254W50L500T200H700-2N_FLT_NF_LL500_SH100_Red_Lumex | https://www.tme.eu/Document/f9e78a70e01250847c87c62edc2b270d/SSL-LX2573SRD.pdf | THD | Lumex | SSL-LX2573SRD |  |  |  |  |  | SSL-LX2573SRD | 2062546
Opto_Lumex.kicad_sym | SSL-LX2573YD, THD, Rectangle 2x5mm, Flat, Yellow, 20mA, Lumex | LED, Rectangle 2x5x7mm, Yellow 585nm, Lens:Flat Yellow Diffused, No-Flange, 10mcd@20mA, 110Â°, Vf:2.1@20mA | LED | D | SSL-LX2573YD | THD_Opto_Lumex:LEDRR254W50L500T200H700-2N_FLT_NF_LL500_SH100_Yellow_Lumex | https://www.tme.eu/Document/338f21c24112093a7ab70dc595a38659/SSL-LX2573YD.pdf | THD | Lumex | SSL-LX2573YD |  |  |  |  |  | SSL-LX2573YD | 1657076
Power_Module_Traco.kicad_sym | TMPW 25-112, THD, 12V, 2A, Traco | AC/DC converter module, 25W, 90Ă·305VAC, 12VDC, Iout: 2083mA, OUT: 1, 87% | PSU | A | TMPW 25-112 | THD_PowerModule_Traco:TMPW25_Traco | https://www.tracopower.com/sites/default/files/products/datasheets/tmpw25_datasheet.pdf | THD | Traco Power | TMPW 25-112 |  |  | 495-TMPW25-112 | 211-0579 |  | TMPW25-112 | 3533102 | 1951-TMPW25-112-ND
Power_Module_Traco.kicad_sym | TMPW 25-124, THD, 24V, 1A, Traco | AC/DC converter module, 25W, 85Ă·264VAC, 24VDC, Iout: 1042mA, OUT: 1, 87% | PSU | A | TMPW 25-124 | THD_PowerModule_Traco:TMPW25_Traco | https://www.tracopower.com/sites/default/files/products/datasheets/tmpw25_datasheet.pdf | THD | Traco Power | TMPW 25-124 |  |  | 495-TMPW25-124 | 211-0583 | 302-24-898 | TMPW25-124 |  | 1951-TMPW25-124-ND | 342572
Relay_Idec.kicad_sym | RJ1S-C-D12, MP, 12V, 12A, Idec | Relay Power 1P2T, Coil: 12VDC/44mA, Contacts: 12A/250VAC (Res), 7.5A/250VAC (Ind), 6A/30VDC |  | K | RJ1S-C-D12 | MECH_noPCB_Relay_Idec:Relay_RJ1S-Cxx_Idec | https://www.mouser.sk/datasheet/2/650/IDEC_RJSeries-1902385.pdf | noPCB | Idec | RJ1S-C-D12 |  |  | 199-RJ1SCD12 |  |  |  | 9535551 |  |  |  | Insert to socket
Relay_Idec.kicad_sym | RJ1S-C-D24, MP, 24V, 12A, Idec | Relay Power 1P2T, Coil: 24VDC/22mA, Contacts: 12A/250VAC (Res), 7.5A/250VAC (Ind), 6A/30VDC |  | K | RJ1S-C-D24 | MECH_noPCB_Relay_Idec:Relay_RJ1S-Cxx_Idec | https://media.digikey.com/pdf/Data%20Sheets/Phoenix%20Contact%20PDFs/1851232.pdf | noPCB | Idec | RJ1S-C-D24 |  |  |  |  |  |  |  |  |  |  | Insert to socket
Relay_Idec.kicad_sym | SJ1S-61, THD, Socket Relay, Idec Style-B | Socket Relay PCB for RJ1S | Socket Relay | K | SJ1S-61 | THD_Relay_Idec:RelaySocket_SJ1S-61_Idec | https://www.tme.eu/Document/f4ce04c0de6aa16ceb848d178d97ac1d/RJSeries-DTE.pdf | THD | Idec | SJ1S-61
Relay_Idec.kicad_sym | SJ1S-61,THD, Socket Relay, Idec | Socket Relay PCB for RJ1S | Socket Relay | K | SJ1S-61 | THD_Relay_Idec:RelaySocket_SJ1S-61_Idec | https://www.tme.eu/Document/f4ce04c0de6aa16ceb848d178d97ac1d/RJSeries-DTE.pdf | THD | Idec | SJ1S-61
Resistor_SMD_0603_0.1W_1perc_Generic.kicad_sym | 100k, SMD 0603, 0.1W, 1% | Resistor, SMD 0603, 0.1W, 1%, Generic | RES | R | 100k/1% | SMD_Resistor_Generic:RESC1608X38N_0603 |  | SMD | Generic
Resistor_SMD_0603_0.1W_1perc_Generic.kicad_sym | 10k, SMD 0603, 0.1W, 1% | Resistor, SMD 0603, 0.1W, 1%, Generic | RES | R | 10k/1% | SMD_Resistor_Generic:RESC1608X38N_0603 |  | SMD | Generic
Resistor_SMD_0603_0.1W_1perc_Generic.kicad_sym | 11k, SMD 0603, 0.1W, 1% | Resistor, SMD 0603, 0.1W, 1%, Generic | RES | R | 11k/1% | SMD_Resistor_Generic:RESC1608X38N_0603 |  | SMD | Generic |  |  |  |  |  |  |  |  |  |  | 11514
Resistor_SMD_0603_0.1W_1perc_Generic.kicad_sym | 120k, SMD 0603, 0.1W, 1% | Resistor, SMD 0603, 0.1W, 1%, Generic | RES | R | 120k/1% | SMD_Resistor_Generic:RESC1608X38N_0603 |  | SMD | Generic
Resistor_SMD_0603_0.1W_1perc_Generic.kicad_sym | 12k, SMD 0603, 0.1W, 1% | Resistor, SMD 0603, 0.1W, 1%, Generic | RES | R | 12k/1% | SMD_Resistor_Generic:RESC1608X38N_0603 |  | SMD | Generic |  |  |  |  |  |  |  |  |  |  | 8030
Resistor_SMD_0603_0.1W_1perc_Generic.kicad_sym | 12k1, SMD 0603, 0.1W, 1% | Resistor, SMD 0603, 0.1W, 1%, Generic | RES | R | 12k1/1% | SMD_Resistor_Generic:RESC1608X38N_0603 |  | SMD | Generic |  |  |  |  |  |  |  |  |  |  | 8247
Resistor_SMD_0603_0.1W_1perc_Generic.kicad_sym | 12k4, SMD 0603, 0.1W, 1% | Resistor, SMD 0603, 0.1W, 1%, Generic | RES | R | 12k4/1% | SMD_Resistor_Generic:RESC1608X38N_0603 |  | SMD | Generic
Resistor_SMD_0603_0.1W_1perc_Generic.kicad_sym | 13k7, SMD 0603, 0.1W, 1% | Resistor, SMD 0603, 0.1W, 1%, Generic | RES | R | 13k7/1% | SMD_Resistor_Generic:RESC1608X38N_0603 |  | SMD | Generic |  |  |  |  |  |  |  |  |  |  | 11740
Resistor_SMD_0603_0.1W_1perc_Generic.kicad_sym | 150R, SMD 0603, 0.1W, 1% | Resistor, SMD 0603, 0.1W, 1%, Generic | RES | R | 150R/1% | SMD_Resistor_Generic:RESC1608X38N_0603 |  | SMD | Generic |  |  |  |  |  |  |  |  |  |  | 8704
Resistor_SMD_0603_0.1W_1perc_Generic.kicad_sym | 150k, SMD 0603, 0.1W, 1% | Resistor, SMD 0603, 0.1W, 1%, Generic | RES | R | 150k/1% | SMD_Resistor_Generic:RESC1608X38N_0603 |  | SMD | Generic |  |  |  |  |  |  |  |  |  |  | 7854
Resistor_SMD_0603_0.1W_1perc_Generic.kicad_sym | 15k, SMD 0603, 0.1W, 1% | Resistor, SMD 0603, 0.1W, 1%, Generic | RES | R | 15k/1% | SMD_Resistor_Generic:RESC1608X38N_0603 |  | SMD | Generic |  |  |  |  |  |  |  |  |  |  | 7903
Resistor_SMD_0603_0.1W_1perc_Generic.kicad_sym | 180R, SMD 0603, 0.1W, 1% | Resistor, SMD 0603, 0.1W, 1%, Generic | RES | R | 180R/1% | SMD_Resistor_Generic:RESC1608X38N_0603 |  | SMD | Generic |  |  |  |  |  |  |  |  |  |  | 8593
Resistor_SMD_0603_0.1W_1perc_Generic.kicad_sym | 180k, SMD 0603, 0.1W, 1% | Resistor, SMD 0603, 0.1W, 1%, Generic | RES | R | 180k/1% | SMD_Resistor_Generic:RESC1608X38N_0603 |  | SMD | Generic
Resistor_SMD_0603_0.1W_1perc_Generic.kicad_sym | 18R, SMD 0603, 0.1W, 1% | Resistor, SMD 0603, 0.1W, 1%, Generic | RES | R | 18R/1% | SMD_Resistor_Generic:RESC1608X38N_0603 |  | SMD | Generic |  |  |  |  |  |  |  |  |  |  | 8891
Resistor_SMD_0603_0.1W_1perc_Generic.kicad_sym | 18k, SMD 0603, 0.1W, 1% | Resistor, SMD 0603, 0.1W, 1%, Generic | RES | R | 18k/1% | SMD_Resistor_Generic:RESC1608X38N_0603 |  | SMD | Generic |  |  |  |  |  |  |  |  |  |  | 7902
Resistor_SMD_0603_0.1W_1perc_Generic.kicad_sym | 1M, SMD 0603, 0.1W, 1% | Resistor, SMD 0603, 0.1W, 1%, Generic | RES | R | 1M/1% | SMD_Resistor_Generic:RESC1608X38N_0603 |  | SMD | Generic |  |  |  |  |  |  |  |  |  |  | 6246
Resistor_SMD_0603_0.1W_1perc_Generic.kicad_sym | 1M2, SMD 0603, 0.1W, 1% | Resistor, SMD 0603, 0.1W, 1%, Generic | RES | R | 1M2/1% | SMD_Resistor_Generic:RESC1608X38N_0603 |  | SMD | Generic |  |  |  |  |  |  |  |  |  |  | 9439
Resistor_SMD_0603_0.1W_1perc_Generic.kicad_sym | 1M5, SMD 0603, 0.1W, 1% | Resistor, SMD 0603, 0.1W, 1%, Generic | RES | R | 1M5/1% | SMD_Resistor_Generic:RESC1608X38N_0603 |  | SMD | Generic |  |  |  |  |  |  |  |  |  |  | 9567
Resistor_SMD_0603_0.1W_1perc_Generic.kicad_sym | 20k, SMD 0603, 0.1W, 1% | Resistor, SMD 0603, 0.1W, 1%, Generic | RES | R | 20k/1% | SMD_Resistor_Generic:RESC1608X38N_0603 |  | SMD | Generic |  |  |  |  |  |  |  |  |  |  | 7791
Resistor_SMD_0603_0.1W_1perc_Generic.kicad_sym | 220k, SMD 0603, 0.1W, 1% | Resistor, SMD 0603, 0.1W, 1%, Generic | RES | R | 220k/1% | SMD_Resistor_Generic:RESC1608X38N_0603 |  | SMD | Generic
Resistor_SMD_0603_0.1W_1perc_Generic.kicad_sym | 22R, SMD 0603, 0.1W, 1% | Resistor, SMD 0603, 0.1W, 1%, Generic | RES | R | 22R/1% | SMD_Resistor_Generic:RESC1608X38N_0603 |  | SMD | Generic |  |  |  |  |  |  |  |  |  |  | 7846
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
Resistor_SMD_0603_0.1W_1perc_Generic.kicad_sym | 680k, SMD 0603, 0.1W, 1% | Resistor, SMD 0603, 0.1W, 1%, Generic | RES | R | 680k/1% | SMD_Resistor_Generic:RESC1608X38N_0603 |  | SMD | Generic |  |  |  |  |  |  |  |  |  |  | 8596
Resistor_SMD_0603_0.1W_1perc_Generic.kicad_sym | 68R, SMD 0603, 0.1W, 1% | Resistor, SMD 0603, 0.1W, 1%, Generic | RES | R | 68R/1% | SMD_Resistor_Generic:RESC1608X38N_0603 |  | SMD | Generic |  |  |  |  |  |  |  |  |  |  | 10720
Resistor_SMD_0603_0.1W_1perc_Generic.kicad_sym | 68k, SMD 0603, 0.1W, 1% | Resistor, SMD 0603, 0.1W, 1%, Generic | RES | R | 68k/1% | SMD_Resistor_Generic:RESC1608X38N_0603 |  | SMD | Generic |  |  |  |  |  |  |  |  |  |  | 7865
Resistor_SMD_0603_0.1W_1perc_Generic.kicad_sym | 6R8, SMD 0603, 0.1W, 1% | Resistor, SMD 0603, 0.1W, 1%, Generic | RES | R | 6R8/1% | SMD_Resistor_Generic:RESC1608X38N_0603 |  | SMD | Generic |  |  |  |  |  |  |  |  |  |  | 8385
Resistor_SMD_0603_0.1W_1perc_Generic.kicad_sym | 6k49, SMD 0603, 0.1W, 1% | Resistor, SMD 0603, 0.1W, 1%, Generic | RES | R | 6k49/1% | SMD_Resistor_Generic:RESC1608X38N_0603 |  | SMD | Generic |  |  |  |  |  |  |  |  |  |  | 11713
Resistor_SMD_0603_0.1W_1perc_Generic.kicad_sym | 6k8, SMD 0603, 0.1W, 1% | Resistor, SMD 0603, 0.1W, 1%, Generic | RES | R | 6k8/1% | SMD_Resistor_Generic:RESC1608X38N_0603 |  | SMD | Generic |  |  |  |  |  |  |  |  |  |  | 8033
Resistor_SMD_0603_0.1W_1perc_Generic.kicad_sym | 750R, SMD 0603, 0.1W, 1% | Resistor, SMD 0603, 0.1W, 1%, Generic | RES | R | 750R/1% | SMD_Resistor_Generic:RESC1608X38N_0603 |  | SMD | Generic |  |  |  |  |  |  |  |  |  |  | 10439
Resistor_SMD_0603_0.1W_1perc_Generic.kicad_sym | 750k, SMD 0603, 0.1W, 1% | Resistor, SMD 0603, 0.1W, 1%, Generic | RES | R | 750k/1% | SMD_Resistor_Generic:RESC1608X38N_0603 |  | SMD | Generic |  |  |  |  |  |  |  |  |  |  | 7119
Resistor_SMD_0603_0.1W_1perc_Generic.kicad_sym | 82k, SMD 0603, 0.1W, 1% | Resistor, SMD 0603, 0.1W, 1%, Generic | RES | R | 82k/1% | SMD_Resistor_Generic:RESC1608X38N_0603 |  | SMD | Generic |  |  |  |  |  |  |  |  |  |  | 7120
Resistor_SMD_0603_0.1W_1perc_Generic.kicad_sym | 8k2, SMD 0603, 0.1W, 1% | Resistor, SMD 0603, 0.1W, 1%, Generic | RES | R | 8k2/1% | SMD_Resistor_Generic:RESC1608X38N_0603 |  | SMD | Generic |  |  |  |  |  |  |  |  |  |  | 7847
Resistor_SMD_1206_0.25W_5perc_Generic.kicad_sym | 0R0, SMD 1206, 2A, 5% | Resistor, SMD 1206, 2A, 5%, Generic | RES,RES1206 | R | 0R | SMD_Resistor_Generic:RESC3116X65N_1206 |  | SMD | Generic |  |  |  |  |  |  |  |  |  |  | 1614
Resistor_SMD_1206_0.25W_5perc_Generic.kicad_sym | 0R33, SMD 1206, 0.25W, 5% | Resistor, SMD 1206, 0.25W, 5%, Generic | RES,RES1206 | R | 0R33 | SMD_Resistor_Generic:RESC3116X65N_1206 |  | SMD | Generic |  |  |  |  |  |  |  |  |  |  | 8936
Resistor_SMD_1206_0.25W_5perc_Generic.kicad_sym | 0R6, SMD 1206, 0.25W, 5% | Resistor, SMD 1206, 0.25W, 5%, Generic | RES,RES1206 | R | 0R6 | SMD_Resistor_Generic:RESC3116X65N_1206 |  | SMD | Generic |  |  |  |  |  |  |  |  |  |  | 7212
Resistor_SMD_1206_0.25W_5perc_Generic.kicad_sym | 100R, SMD 1206, 0.25W, 5% | Resistor, SMD 1206, 0.25W, 5%, Generic | RES,RES1206 | R | 100R | SMD_Resistor_Generic:RESC3116X65N_1206 |  | SMD | Generic |  |  |  |  |  |  |  |  |  |  | 1615
Resistor_SMD_1206_0.25W_5perc_Generic.kicad_sym | 10M, SMD 1206, 0.25W, 5% | Resistor, SMD 1206, 0.25W, 5%, Generic | RES,RES1206 | R | 10M | SMD_Resistor_Generic:RESC3116X65N_1206 |  | SMD | Generic |  |  |  |  |  |  |  |  |  |  | 3335
Resistor_SMD_1206_0.25W_5perc_Generic.kicad_sym | 10k, SMD 1206, 0.25W, 5% | Resistor, SMD 1206, 0.25W, 5%, Generic | RES,RES1206 | R | 10k | SMD_Resistor_Generic:RESC3116X65N_1206 |  | SMD | Generic
Resistor_SMD_1206_0.25W_5perc_Generic.kicad_sym | 12R, SMD 1206, 0.25W, 5% | Resistor, SMD 1206, 0.25W, 5%, Generic | RES,RES1206 | R | 12R | SMD_Resistor_Generic:RESC3116X65N_1206 |  | SMD | Generic |  |  |  |  |  |  |  |  |  |  | 1637
Resistor_SMD_1206_0.25W_5perc_Generic.kicad_sym | 18R, SMD 1206, 0.25W, 5% | Resistor, SMD 1206, 0.25W, 5%, Generic | RES,RES1206 | R | 18R | SMD_Resistor_Generic:RESC3116X65N_1206 |  | SMD | Generic |  |  |  |  |  |  |  |  |  |  | 3322
Resistor_SMD_1206_0.25W_5perc_Generic.kicad_sym | 18k, SMD 1206, 0.25W, 5% | Resistor, SMD 1206, 0.25W, 5%, Generic | RES,RES1206 | R | 18k | SMD_Resistor_Generic:RESC3116X65N_1206 |  | SMD | Generic |  |  |  |  |  |  |  |  |  |  | 1651
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
Resistor_SMD_1206_0.25W_5perc_Generic.kicad_sym | 680k, SMD 1206, 0.25W, 5% | Resistor, SMD 1206, 0.25W, 5%, Generic | RES,RES1206 | R | 680k | SMD_Resistor_Generic:RESC3116X65N_1206 |  | SMD | Generic |  |  |  |  |  |  |  |  |  |  | 3717
Resistor_SMD_1206_0.25W_5perc_Generic.kicad_sym | 6M8, SMD 1206, 0.25W, 5% | Resistor, SMD 1206, 0.25W, 5%, Generic | RES,RES1206 | R | 6M8 | SMD_Resistor_Generic:RESC3116X65N_1206 |  | SMD | Generic |  |  |  |  |  |  |  |  |  |  | 3334
Resistor_SMD_1206_0.25W_5perc_Generic.kicad_sym | 6R8, SMD 1206, 0.25W, 5% | Resistor, SMD 1206, 0.25W, 5%, Generic | RES,RES1206 | R | 6R8 | SMD_Resistor_Generic:RESC3116X65N_1206 |  | SMD | Generic |  |  |  |  |  |  |  |  |  |  | 3321
Resistor_SMD_1206_0.25W_5perc_Generic.kicad_sym | 820R, SMD 1206, 0.25W, 5% | Resistor, SMD 1206, 0.25W, 5%, Generic | RES,RES1206 | R | 820R | SMD_Resistor_Generic:RESC3116X65N_1206 |  | SMD | Generic |  |  |  |  |  |  |  |  |  |  | 1639
Resistor_SMD_1206_0.25W_5perc_Generic.kicad_sym | 8M2, SMD 1206, 0.25W, 5% | Resistor, SMD 1206, 0.25W, 5%, Generic | RES,RES1206 | R | 8M2 | SMD_Resistor_Generic:RESC3116X65N_1206 |  | SMD | Generic |  |  |  |  |  |  |  |  |  |  | 1628
Resistor_SMD_1206_0.25W_5perc_Generic.kicad_sym | 8R2, SMD 1206, 0.25W, 5% | Resistor, SMD 1206, 0.25W, 5%, Generic | RES,RES1206 | R | 8R2 | SMD_Resistor_Generic:RESC3116X65N_1206 |  | SMD | Generic |  |  |  |  |  |  |  |  |  |  | 1611
Resistor_SMD_2512_1W_1perc_600ppm_Yageo_RL.kicad_sym | 0R33, SMD 2512, 1W, 1%, 600ppm | Resistor, SMD 2512, 1W, 1%, 600ppm, RL Series, Yageo | RES | R | 0R33/1W/1% | SMD_Resistor_Generic:RESC6432X60N_2512 | https://www.farnell.com/datasheets/3046086.pdf | SMD | Yageo | RL2512FK-070R33L | R33 | C314696 | 603-RL252FK070R33L | 199-6137 |  |  | 1779467 | 311-0.33TCT-ND | 76196 | 8595
Resistor_THD_0207_0.6W_5perc_50ppm_Generic.kicad_sym | 0R10, THD 0207, 0.6W, 5%, +/-50ppm | Resistor, THD 0207, 0.6W, 5%, +/-50ppm, Generic | RES | R | 0R10/0.6W | THD_Resistor_Generic:RESAD1016W60L630D250-0207 |  | THD | Generic |  |  |  |  |  |  |  |  |  |  | 10728
Resistor_THD_0207_0.6W_5perc_50ppm_Generic.kicad_sym | 0R22, THD 0207, 0.6W, 5%, +/-50ppm | Resistor, THD 0207, 0.6W, 5%, +/-50ppm, Generic | RES | R | 0R22/0.6W | THD_Resistor_Generic:RESAD1016W60L630D250-0207 |  | THD | Generic |  |  |  |  |  |  |  |  |  |  | 1254
Resistor_THD_0207_0.6W_5perc_50ppm_Generic.kicad_sym | 0R33, THD 0207, 0.6W, 5%, +/-50ppm | Resistor, THD 0207, 0.6W, 5%, +/-50ppm, Generic | RES | R | 0R33/0.6W | THD_Resistor_Generic:RESAD1016W60L630D250-0207 |  | THD | Generic |  |  |  |  |  |  |  |  |  |  | 1462
Resistor_THD_0207_0.6W_5perc_50ppm_Generic.kicad_sym | 0R47, THD 0207, 0.6W, 5%, +/-50ppm | Resistor, THD 0207, 0.6W, 5%, +/-50ppm, Generic | RES | R | 0R47/0.6W | THD_Resistor_Generic:RESAD1016W60L630D250-0207 |  | THD | Generic |  |  |  |  |  |  |  |  |  |  | 1461
Resistor_THD_0207_0.6W_5perc_50ppm_Generic.kicad_sym | 100R, THD 0207, 0.6W, 5%, +/-50ppm | Resistor, THD 0207, 0.6W, 5%, +/-50ppm, Generic | RES | R | 100R/0.6W | THD_Resistor_Generic:RESAD1016W60L630D250-0207 |  | THD | Generic |  |  |  |  |  |  |  |  |  |  | 337
Resistor_THD_0207_0.6W_5perc_50ppm_Generic.kicad_sym | 100k, THD 0207, 0.6W, 5%, +/-50ppm | Resistor, THD 0207, 0.6W, 5%, +/-50ppm, Generic | RES | R | 100k/0.6W | THD_Resistor_Generic:RESAD1016W60L630D250-0207 |  | THD | Generic |  |  |  |  |  |  |  |  |  |  | 680
Resistor_THD_0207_0.6W_5perc_50ppm_Generic.kicad_sym | 10M, THD 0207, 0.6W, 5%, +/-50ppm | Resistor, THD 0207, 0.6W, 5%, +/-50ppm, Generic | RES | R | 10M/0.6W | THD_Resistor_Generic:RESAD1016W60L630D250-0207 |  | THD | Generic |  |  |  |  |  |  |  |  |  |  | 447
Resistor_THD_0207_0.6W_5perc_50ppm_Generic.kicad_sym | 10R, THD 0207, 0.6W, 5%, +/-50ppm | Resistor, THD 0207, 0.6W, 5%, +/-50ppm, Generic | RES | R | 10R/0.6W | THD_Resistor_Generic:RESAD1016W60L630D250-0207 |  | THD | Generic |  |  |  |  |  |  |  |  |  |  | 852
Resistor_THD_0207_0.6W_5perc_50ppm_Generic.kicad_sym | 10k, THD 0207, 0.6W, 5%, +/-50ppm | Resistor, THD 0207, 0.6W, 5%, +/-50ppm, Generic | RES | R | 10k/0.6W | THD_Resistor_Generic:RESAD1016W60L630D250-0207 |  | THD | Generic |  |  |  |  |  |  |  |  |  |  | 398
Resistor_THD_0207_0.6W_5perc_50ppm_Generic.kicad_sym | 11k, THD 0207, 0.6W, 5%, +/-50ppm | Resistor, THD 0207, 0.6W, 5%, +/-50ppm, Generic | RES | R | 11k/0.6W | THD_Resistor_Generic:RESAD1016W60L630D250-0207 |  | THD | Generic |  |  |  |  |  |  |  |  |  |  | 8191
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
Resistor_THD_0207_0.6W_5perc_50ppm_Generic.kicad_sym | 470k, THD 0207, 0.6W, 5%, +/-50ppm | Resistor, THD 0207, 0.6W, 5%, +/-50ppm, Generic | RES | R | 470k/0.6W | THD_Resistor_Generic:RESAD1016W60L630D250-0207 |  | THD | Generic |  |  |  |  |  |  |  |  |  |  | 2179
Resistor_THD_0207_0.6W_5perc_50ppm_Generic.kicad_sym | 47R, THD 0207, 0.6W, 5%, +/-50ppm | Resistor, THD 0207, 0.6W, 5%, +/-50ppm, Generic | RES | R | 47R/0.6W | THD_Resistor_Generic:RESAD1016W60L630D250-0207 |  | THD | Generic |  |  |  |  |  |  |  |  |  |  | 386
Resistor_THD_0207_0.6W_5perc_50ppm_Generic.kicad_sym | 47k, THD 0207, 0.6W, 5%, +/-50ppm | Resistor, THD 0207, 0.6W, 5%, +/-50ppm, Generic | RES | R | 47k/0.6W | THD_Resistor_Generic:RESAD1016W60L630D250-0207 |  | THD | Generic |  |  |  |  |  |  |  |  |  |  | 913
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
