Z-Elektrik/LIB/3dmodels/THD_LED_BrightLed.3dshape/LEDRR254W50L500T190H700-2_FLT_NF_LL500_SH150_Green.step

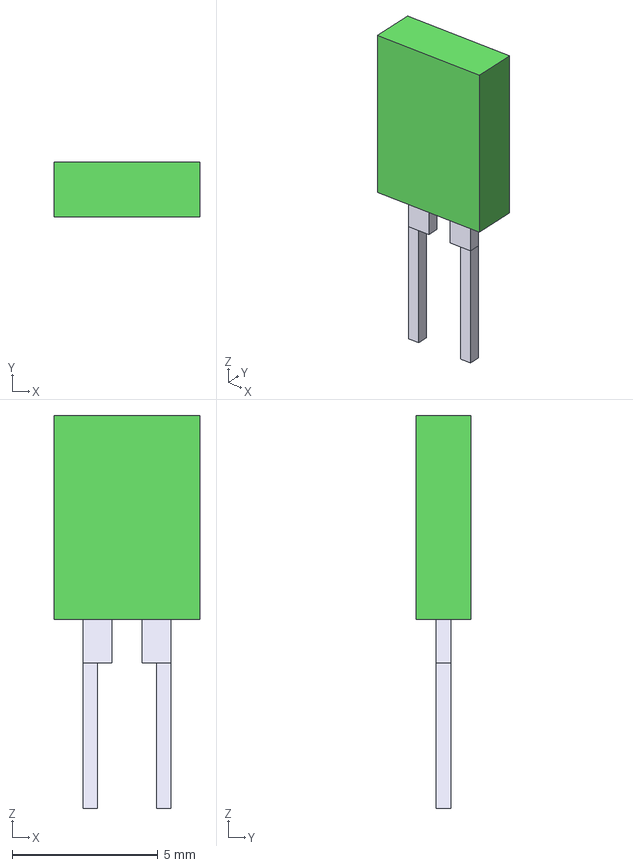
[picture p1: CAD file, 2026-07-08]
3dmodels/THD_LED_BrightLed.3dshape/LEDRR254W50L500T190H700-2_FLT_NF_LL500_SH150_Green.step
5.00 x 1.90 x 13.5 mm
Lens
PinA
PinB
StandOff
