Z-Elektrik/LIB/3dmodels/THD_LED_Kingbright.3dshape/LEDRD254W50D300H500-3_CVX_FD_LL500_SH143_Red.step

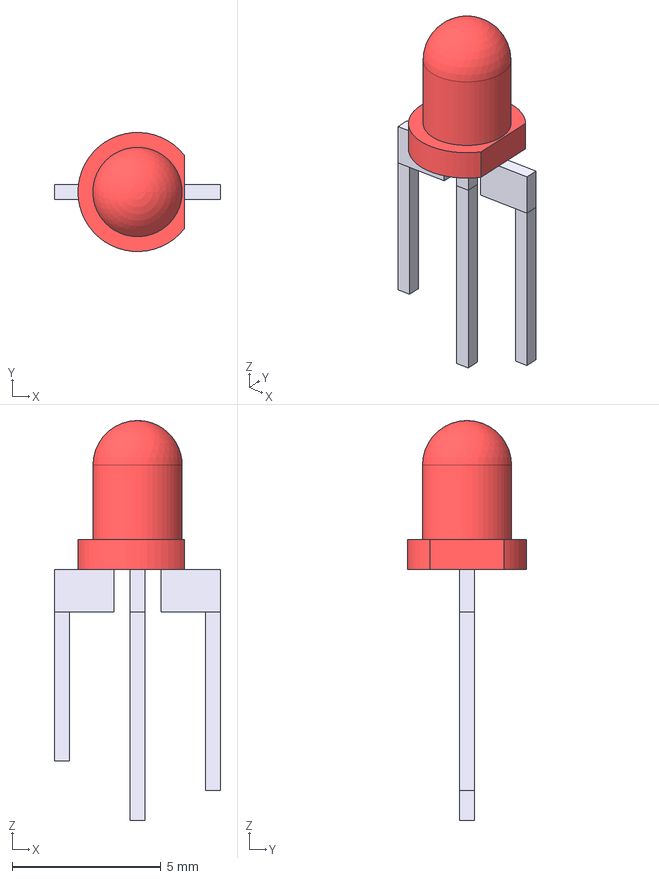
[picture p2: CAD file, 2026-07-08]
3dmodels/THD_LED_Kingbright.3dshape/LEDRD254W50D300H500-3_CVX_FD_LL500_SH143_Red.step
5.58 x 4.00 x 13.4 mm
Lens
Mark
PinA
PinB
StandOff
PinC
XY-plane006
