Z-Elektrik/LIB/3dmodels/THD_LED_Lumex.3dshape/LEDRR254W50L500T200H700-2_FLT_NF_LL500_SH100_Yellow.step

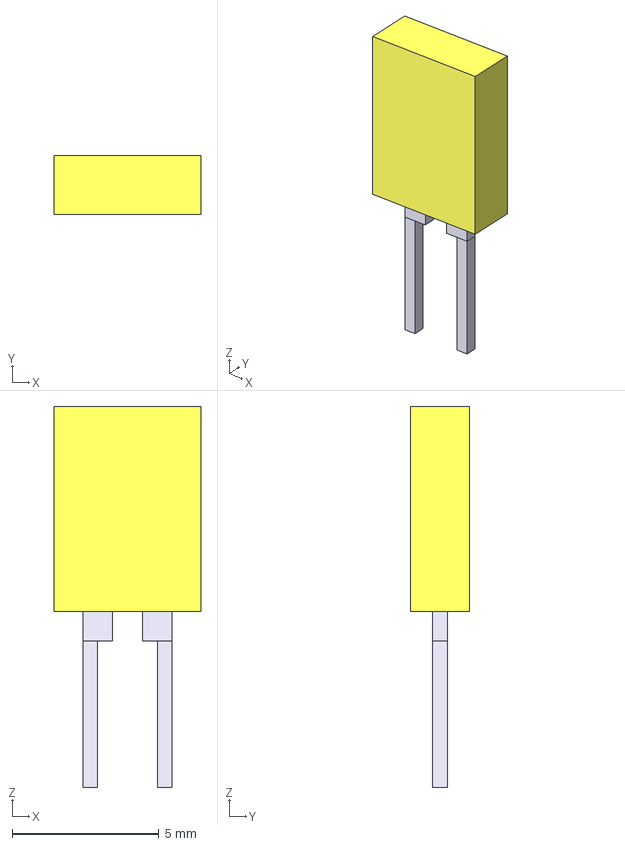
[picture p3: CAD file, 2026-07-08]
3dmodels/THD_LED_Lumex.3dshape/LEDRR254W50L500T200H700-2_FLT_NF_LL500_SH100_Yellow.step
5.00 x 2.00 x 13.0 mm
Lens
PinA
PinB
StandOff
