Z-Elektrik/LIB/3dmodels/THD_LED_Kingbright.3dshape/LEDRD254W50D500H860-2_CVX_FD_LL500_SH100_Red.step

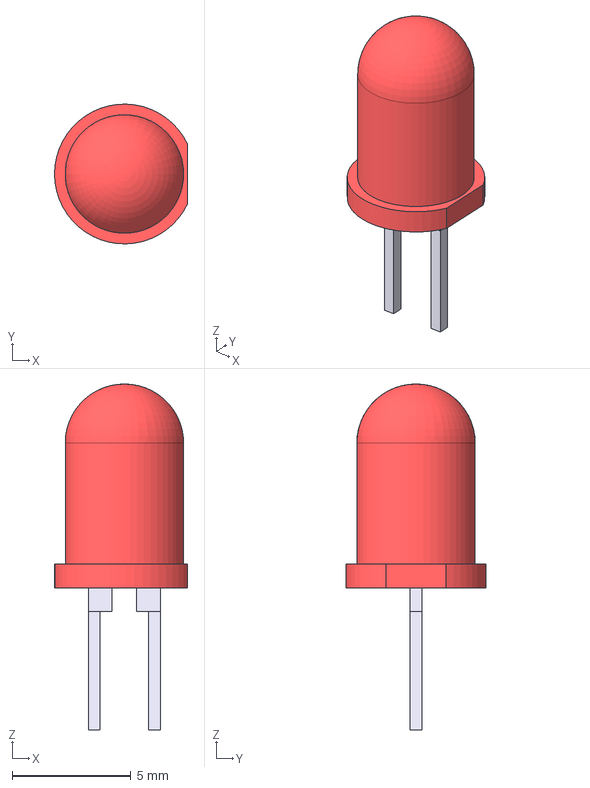
[picture p4: CAD file, 2026-07-08]
3dmodels/THD_LED_Kingbright.3dshape/LEDRD254W50D500H860-2_CVX_FD_LL500_SH100_Red.step
5.61 x 5.90 x 14.6 mm
Lens
Mark
PinA
PinB
StandOff
