Z-Elektrik/LIB/3dmodels/THD_LED_Kingbright.3dshape/LEDRD254W50D500H860-2_CVX_NF_LL500_SH20_Green.step

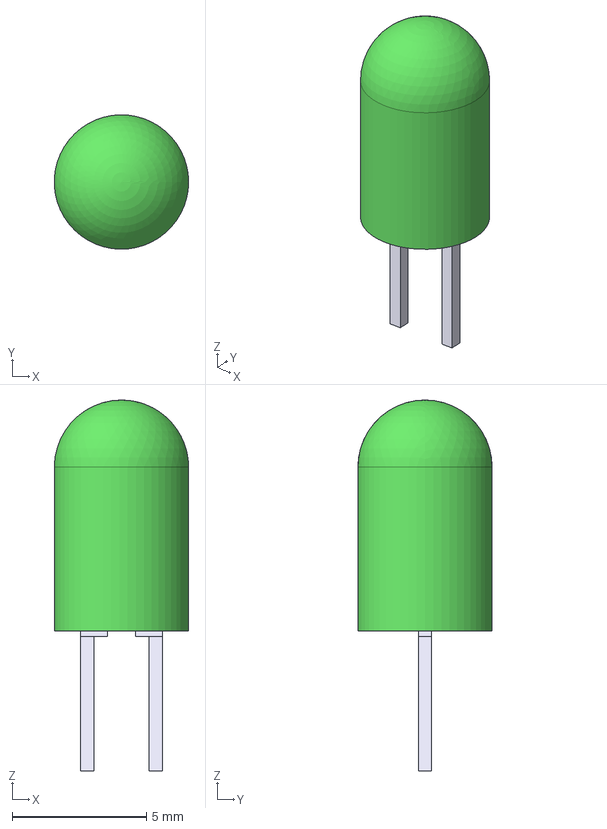
[picture p5: CAD file, 2026-07-08]
3dmodels/THD_LED_Kingbright.3dshape/LEDRD254W50D500H860-2_CVX_NF_LL500_SH20_Green.step
5.00 x 5.00 x 13.8 mm
Lens
PinA
PinB
StandOff
