Z-Elektrik/LIB/3dmodels/THD_LED_Kingbright.3dshape/LEDRD254W50D290H460-2_CVX_FR_LL500_SH80_Violet.step

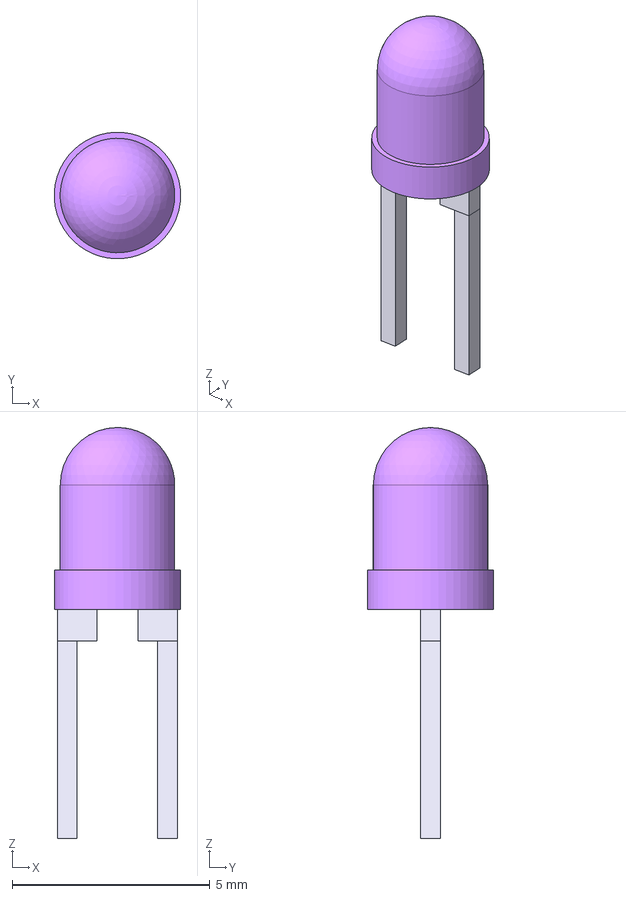
[picture p6: CAD file, 2026-07-08]
3dmodels/THD_LED_Kingbright.3dshape/LEDRD254W50D290H460-2_CVX_FR_LL500_SH80_Violet.step
3.20 x 3.20 x 10.4 mm
Lens
Mark
PinA
PinB
Shaping area
