Z-Elektrik/LIB/3dmodels/THD_LED_Kingbright.3dshape/LEDRD254W50D290H460-2_CVX_FR_LL500_SH100_Blue.step

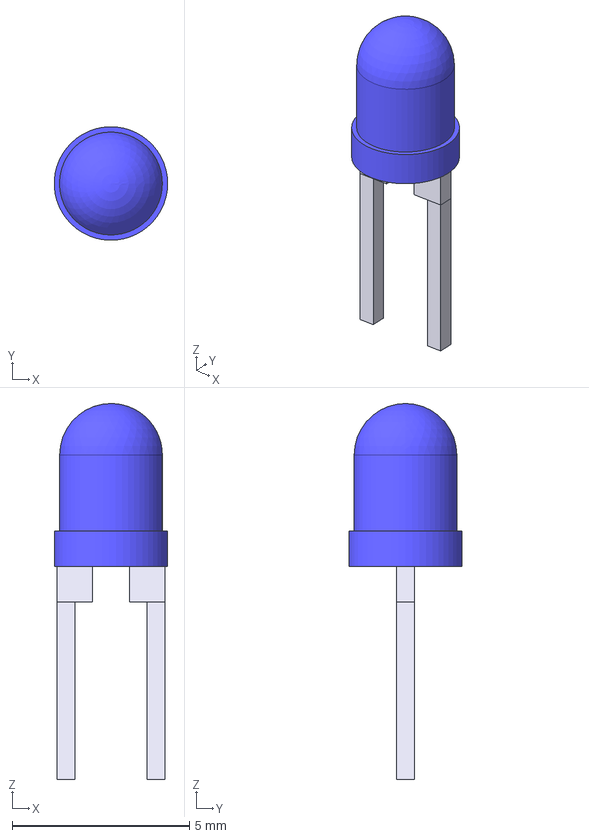
[picture p7: CAD file, 2026-07-08]
3dmodels/THD_LED_Kingbright.3dshape/LEDRD254W50D290H460-2_CVX_FR_LL500_SH100_Blue.step
3.20 x 3.20 x 10.6 mm
Lens
Mark
PinA
PinB
Shaping area
