Z-Elektrik/LIB/3dmodels/THD_LED_Kingbright.3dshape/L-934MD-1LI1LGD.step

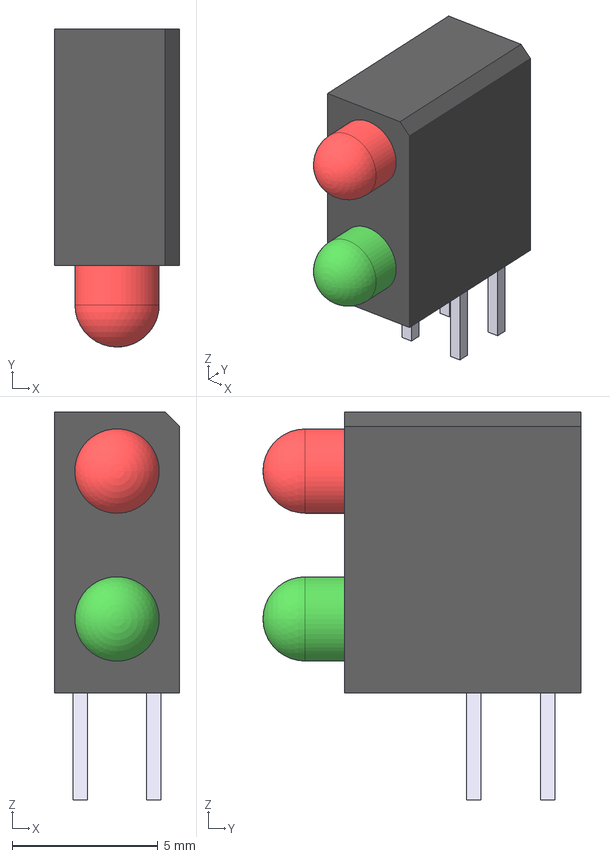
[picture p8: CAD file, 2026-07-08]
3dmodels/THD_LED_Kingbright.3dshape/L-934MD-1LI1LGD.step
4.30 x 10.9 x 13.3 mm
A1_Pad
K1_Pad
A2_Pad
K2_Pad
Red_LED_Obluk
Green_LED_Obluk
