Z-Elektrik/LIB/3dmodels/THD_LED_Kingbright.3dshape/LEDRD254W50D180H310-2_CVX_FC_LL500_SH100_Red.step

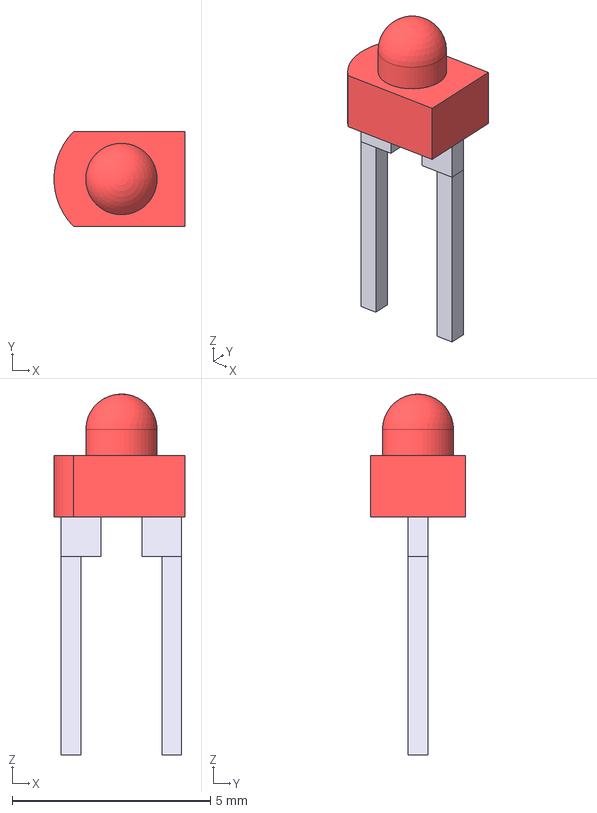
[picture p9: CAD file, 2026-07-08]
3dmodels/THD_LED_Kingbright.3dshape/LEDRD254W50D180H310-2_CVX_FC_LL500_SH100_Red.step
3.30 x 2.40 x 9.10 mm
Lens
Mark
PinA
PinB
StandOff
