Z-Elektrik/LIB/3dmodels/THD_LED_Kingbright.3dshape/LEDRD254W50D500H860-4_CVX_Fd_LL500_SH300_White.step

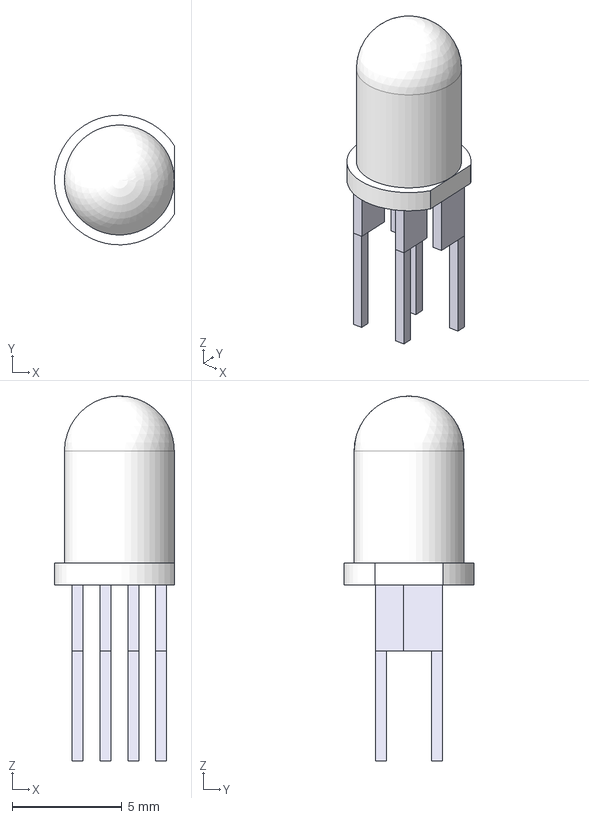
[picture p10: CAD file, 2026-07-08]
3dmodels/THD_LED_Kingbright.3dshape/LEDRD254W50D500H860-4_CVX_Fd_LL500_SH300_White.step
5.46 x 5.90 x 16.6 mm
Lens
Mark
PinA
PinB
PinC
PinD
Shaping area
