Z-Elektrik/LIB/3dmodels/THD_LED_Kingbright.3dshape/LEDRD254W50D300H500-2_CVX_FD_LL500_SH30_Green.step

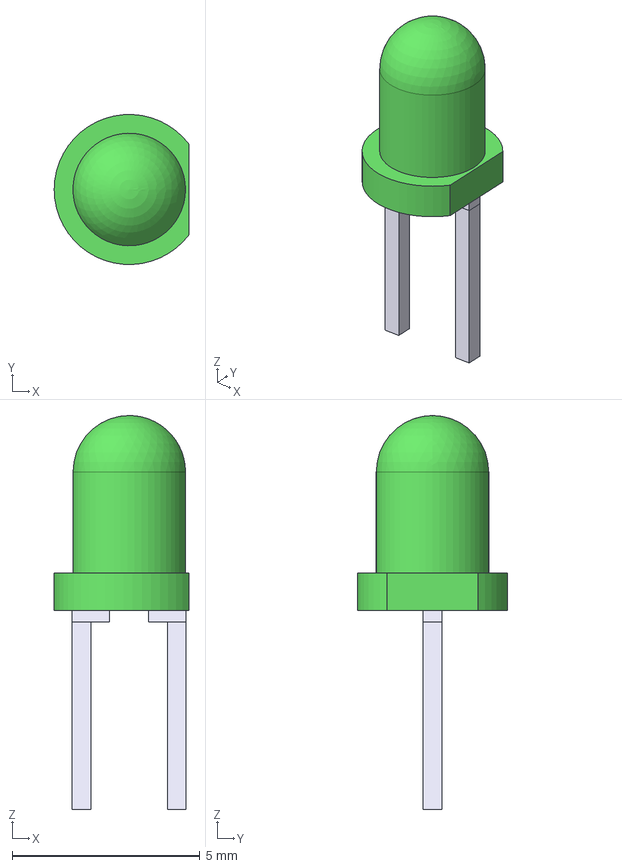
[picture p11: CAD file, 2026-07-08]
3dmodels/THD_LED_Kingbright.3dshape/LEDRD254W50D300H500-2_CVX_FD_LL500_SH30_Green.step
3.59 x 4.00 x 10.5 mm
Lens
Mark
PinA
PinB
StandOff
