Z-Elektrik/LIB/3dmodels/THD_LED_Kingbright.3dshape/LEDRD254W50D500H860-3_CVX_FD_LL500_SH175_Red.step

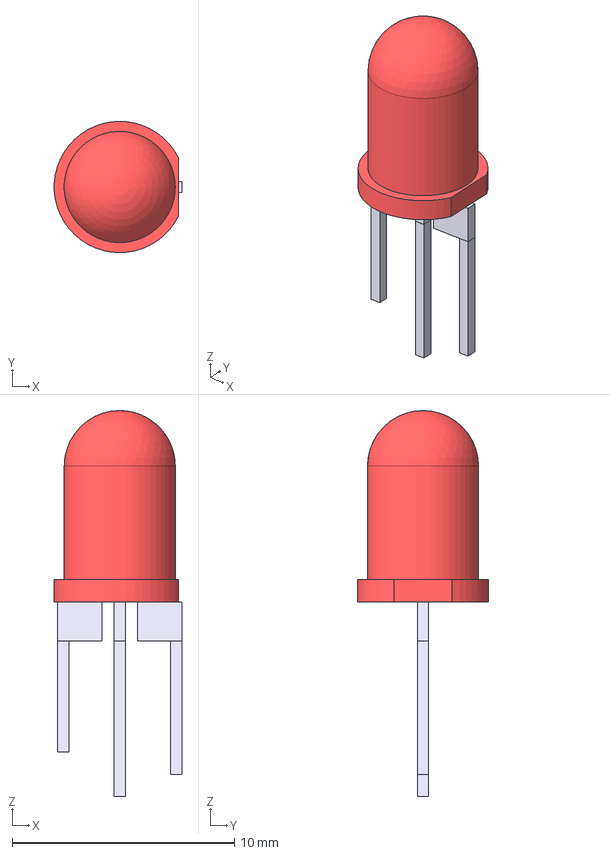
[picture p12: CAD file, 2026-07-08]
3dmodels/THD_LED_Kingbright.3dshape/LEDRD254W50D500H860-3_CVX_FD_LL500_SH175_Red.step
5.73 x 5.90 x 17.4 mm
Lens
Mark
PinA
PinB
StandOff
PinC
XY-plane006
