Z-Elektrik/LIB/3dmodels/THD_LED_Kingbright.3dshape/LEDRD254W50D500H860-2_CVX_NF_LL500_SH100_Green.step

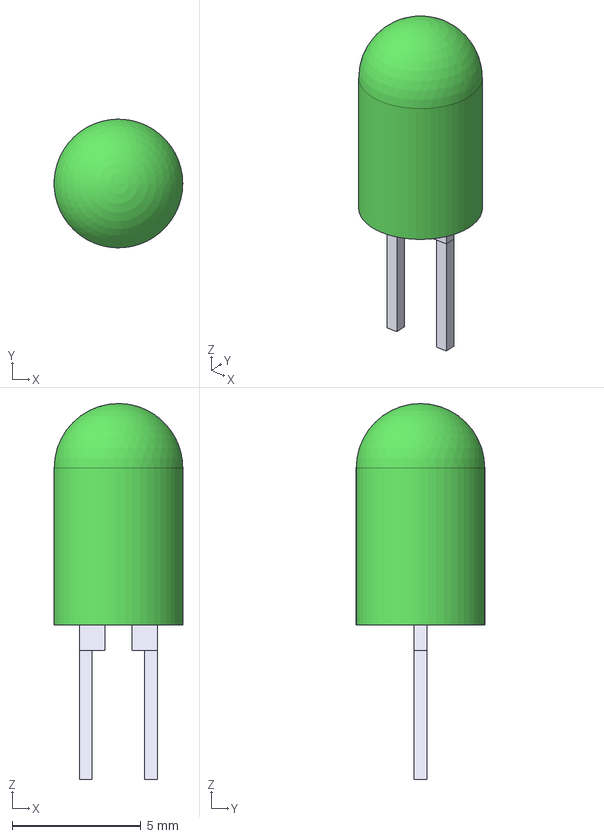
[picture p13: CAD file, 2026-07-08]
3dmodels/THD_LED_Kingbright.3dshape/LEDRD254W50D500H860-2_CVX_NF_LL500_SH100_Green.step
5.00 x 5.00 x 14.6 mm
Lens
PinA
PinB
Shaping area
