Z-Elektrik/LIB/3dmodels/THD_LED_Kingbright.3dshape/LEDRD254W50D300H600-2_FLT_FR_LL500_SH50_Red.step

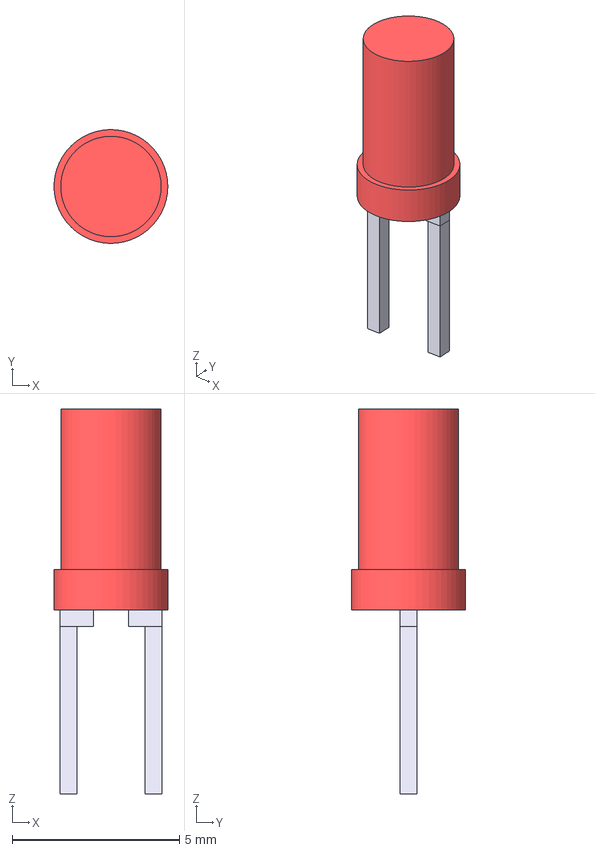
[picture p14: CAD file, 2026-07-08]
3dmodels/THD_LED_Kingbright.3dshape/LEDRD254W50D300H600-2_FLT_FR_LL500_SH50_Red.step
3.40 x 3.40 x 11.5 mm
Lens
Mark
PinA
PinB
Shaping area
