Z-Elektrik/LIB/3dmodels/THD_LED_Kingbright.3dshape/LEDRD254W50D180H310-2_CVX_FC_LL500_SH100.FCStd

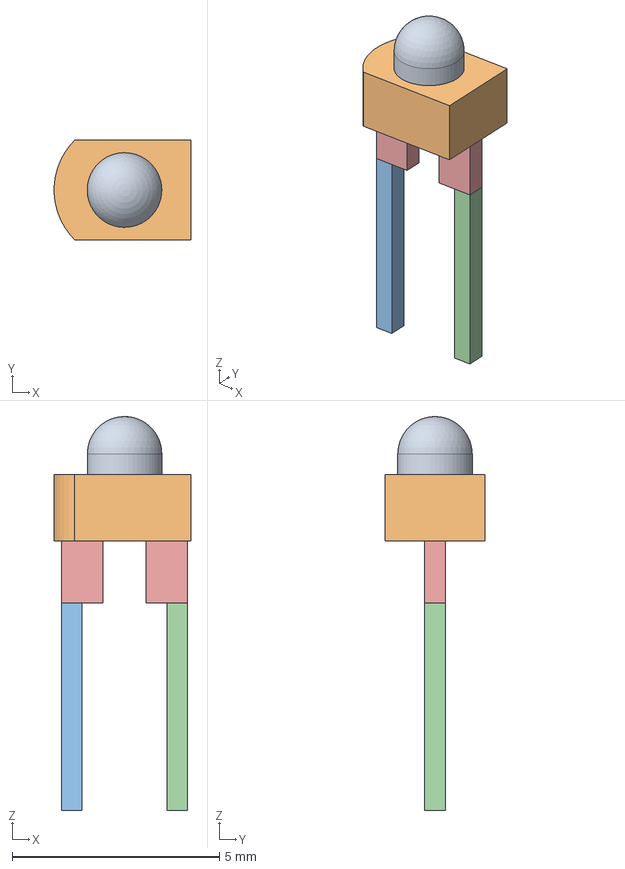
[picture p15: CAD file, 2026-06-26]
3dmodels/THD_LED_Kingbright.3dshape/LEDRD254W50D180H310-2_CVX_FC_LL500_SH100.FCStd
3.30 x 2.40 x 9.50 mm
Lens
Mark
PinA
PinB
StandOff
