Z-Elektrik/LIB/3dmodels/THD_LED_Kingbright.3dshape/LEDRD254W50D300H620-2_CVX_FR_LL500.FCStd

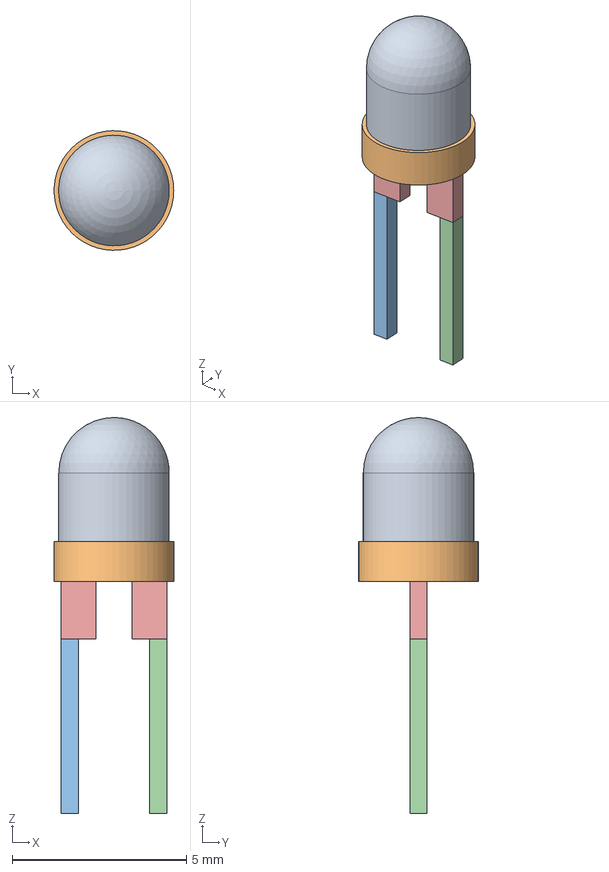
[picture p16: CAD file, 2026-06-26]
3dmodels/THD_LED_Kingbright.3dshape/LEDRD254W50D300H620-2_CVX_FR_LL500.FCStd
3.43 x 3.43 x 11.3 mm
Lens
Mark
PinA
PinB
Shaping area
