Z-Elektrik/LIB/3dmodels/THD_LED_Kingbright.3dshape/LEDRD254W50D300H500-3_CVX_FDR_LL500_SH160.FCStd

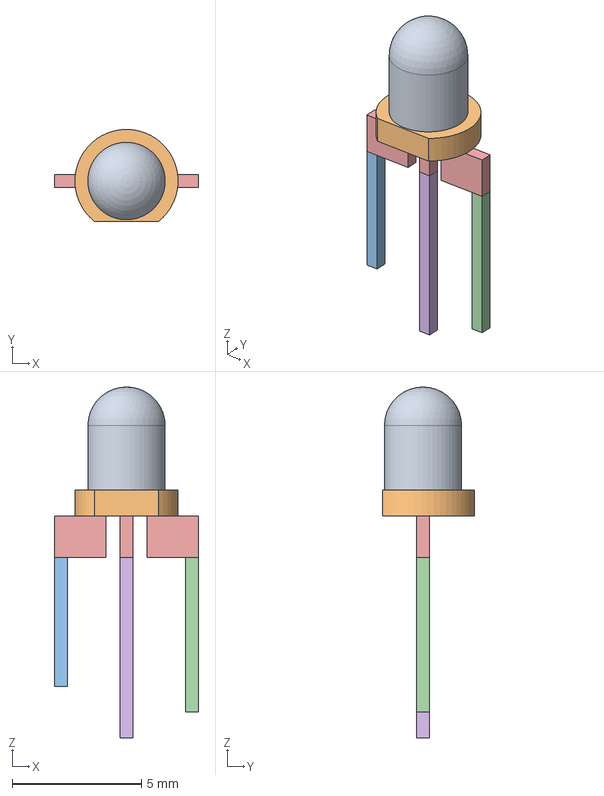
[picture p17: CAD file, 2026-06-26]
3dmodels/THD_LED_Kingbright.3dshape/LEDRD254W50D300H500-3_CVX_FDR_LL500_SH160.FCStd
5.58 x 3.57 x 13.6 mm
Lens
Mark
PinA
PinB
StandOff
PinC
