Z-Elektrik/LIB/(list of files, cad)

Other CAD files:
3dmodels/THD_LED_BrightLed.3dshape/LEDRR254W50L500T190H700-2_FLT_NF_LL500_SH150.FCStd
3dmodels/THD_LED_Lumex.3dshape/LEDRR254W50L500T200H700-2_FLT_NF_LL500_SH100_Green.step
3dmodels/THD_LED_Lumex.3dshape/LEDRR254W50L500T200H700-2_FLT_NF_LL500_SH100_Blue.step
3dmodels/THD_LED_Lumex.3dshape/LEDRR254W50L500T200H700-2_FLT_NF_LL500_SH100_White.step
3dmodels/THD_LED_Kingbright.3dshape/LEDRD254W50D500H860-2_CVX_FD_LL500_SH100_Green.step
3dmodels/THD_LED_Lumex.3dshape/LEDRR254W50L500T200H700-2_FLT_NF_LL500_SH100_Red.step
3dmodels/THD_LED_Kingbright.3dshape/LEDRD254W50D290H460-2_CVX_FR_LL500_SH50_Orange.step
3dmodels/THD_LED_Kingbright.3dshape/LEDRR254W50L500T200H700-2_FLT_NF_LL500_SH100_Red.step
3dmodels/THD_LED_Kingbright.3dshape/LEDRD254W50D290H460-2_CVX_FR_LL500_SH80_White.step
3dmodels/THD_LED_Kingbright.3dshape/LEDRD254W50D500H860-2_CVX_FD_LL500_SH100_Yellow.step
3dmodels/THD_LED_Kingbright.3dshape/LEDRD254W50D290H460-2_CVX_FR_LL500_SH50_Yellow.step
3dmodels/THD_LED_Kingbright.3dshape/LEDRR254W50L500T200H700-2_FLT_NF_LL500_SH100_Green.step
3dmodels/THD_LED_Kingbright.3dshape/LEDRD254W50D290H460-2_CVX_FR_LL500_SH50_Red.step
3dmodels/THD_LED_Kingbright.3dshape/LEDRD254W50D290H460-2_CVX_FR_LL500_SH100_White.step
3dmodels/THD_LED_Kingbright.3dshape/LEDRD254W50D180H310-2_CVX_FC_LL500_SH100_Green.step
3dmodels/THD_LED_Kingbright.3dshape/LEDRD254W50D290H460-2_CVX_FR_LL500_SH50_White.step
3dmodels/THD_LED_Kingbright.3dshape/LEDRD254W50D290H460-2_CVX_FR_LL500_SH80_Red.step
3dmodels/THD_LED_Kingbright.3dshape/LEDRD254W50D290H460-2_CVX_FR_LL500_SH80_Orange.step
3dmodels/THD_LED_Kingbright.3dshape/LEDRD254W50D500H860-2_CVX_FD_LL500_SH100_Orange.step
3dmodels/THD_LED_Kingbright.3dshape/LEDRD254W50D290H460-2_CVX_FR_LL500_SH50_Green.step
3dmodels/THD_LED_Kingbright.3dshape/LEDRD254W50D290H460-2_CVX_FR_LL500_SH100_Green.step
3dmodels/THD_LED_Kingbright.3dshape/LEDRD254W50D300H500-3_CVX_FD_LL500_SH143_White.step
3dmodels/THD_LED_Kingbright.3dshape/LEDRD254W50D290H460-2_CVX_FR_LL500_SH100_Yellow.step
3dmodels/THD_LED_Kingbright.3dshape/LEDRD254W50D290H460-2_CVX_FR_LL500_SH80_Blue.step
3dmodels/THD_LED_Kingbright.3dshape/LEDRD254W50D500H860-3_CVX_FD_LL500_SH175_Green.step
3dmodels/THD_LED_Kingbright.3dshape/LEDRD254W50D300H500-3_CVX_FD_LL500_SH143_Green.step
3dmodels/THD_LED_Kingbright.3dshape/LEDRD254W50D290H460-2_CVX_FR_LL500_SH80_Green.step
3dmodels/THD_LED_Kingbright.3dshape/LEDRD254W50D500H860-2_CVX_FD_LL500_SH100_Blue.step
3dmodels/THD_LED_Kingbright.3dshape/LEDRD254W50D180H310-2_CVX_FC_LL500_SH100_Yellow.step
3dmodels/THD_LED_Kingbright.3dshape/LEDRD254W50D290H460-2_CVX_FR_LL500_SH100_Orange.step
3dmodels/THD_LED_Kingbright.3dshape/LEDRD254W50D290H460-2_CVX_FR_LL500_SH80_Yellow.step
3dmodels/THD_LED_Kingbright.3dshape/LEDRD254W50D500H860-3_CVX_FD_LL500_SH175_White.step
3dmodels/THD_LED_Kingbright.3dshape/LEDRD254W50D290H460-2_CVX_FR_LL500_SH50_Blue.step
3dmodels/THD_LED_Kingbright.3dshape/LEDRD254W50D290H460-2_CVX_FR_LL500_SH100_Red.step
3dmodels/THD_LED_Kingbright.3dshape/LEDRD254W50D500H860-2_CVX_FD_LL500_SH100_White.step
3dmodels/THD_LED_Kingbright.3dshape/L-934MD-1LI1LGD.20260617-143825.FCStd
3dmodels/THD_LED_Kingbright.3dshape/LEDRD254W50D300H500-3_CVX_FD_LL500_SH143.FCStd
3dmodels/THD_LED_Kingbright.3dshape/LEDRD254W50D500H860-2_CVX_FD_LL500_SH100.FCStd
3dmodels/THD_LED_Kingbright.3dshape/LEDRD254W50D500H860-3_CVX_FD_LL500_SH175.FCStd
3dmodels/THD_LED_Kingbright.3dshape/LEDRD254W50D500H860-4_CVX_NF_LL500_SHxxx.FCStd
3dmodels/THD_LED_Kingbright.3dshape/LEDRD254W50D500H860-2_CVX_NF_LL500_SH100.FCStd
3dmodels/THD_LED_Kingbright.3dshape/LEDRR254W50L500T200H700-2_FLT_NF_LL500_SH100.FCStd
