Z-Elektrik/LIB/(commit log)

2024-01-29 Initial commit
    Repo created
    [DG127-5.0_5.08-xxP-4Y-00AH.SLDPRT, DG127-THR-5.0_5.08-xxP-4Y-80AH.SLDPRT, DG127A-5.0_5.08-xxP-4Y-00AH.SLDPRT, DG127R-5.0_5.08-xxP-4Y-00AH.SLDPRT, DG127S-5.0_5.08-xxP-14-00AH.SLDPRT, Raystar.fcstd]
2024-03-27 add capacitors
2024-03-27 add 3d
    [DG127-5.0_5.08-xxP-4Y-00AH.SLDPRT, DG127-THR-5.0_5.08-xxP-4Y-80AH.SLDPRT, DG127A-5.0_5.08-xxP-4Y-00AH.SLDPRT, DG127R-5.0_5.08-xxP-4Y-00AH.SLDPRT, DG127S-5.0_5.08-xxP-14-00AH.SLDPRT, Raystar.fcstd]
2024-05-16 Footprint corrections
    - Remove start of footprint coords mark from courtyard layer
    - fix unclosed courtyards
2024-06-07 new TE Relay
2024-09-22 Add SRPassives thermistor
2024-09-25 Update to v8
    KICAD7_3DMODEL_DIR changed to KICAD8_3DMODEL_DIR
2024-09-28 Add CAPC footprints by IPC density
2024-10-03 Add Wurth Connector
2024-10-04 Add Sockets
2024-10-07 Header, Connector update
2024-10-07 LED 0603 text correction
2024-10-07 Add universal power symbols
2024-10-07 Fix footprint
2024-10-14 Rename power_symbol lib, add net_tie
2024-10-15 Switch renumber
2024-10-23 Omron Switch B3W_90xx added
2024-10-24 Add Omron switch
2024-11-21 Add tolerance to capacitor libs name
2024-11-23 Add 0603 LEDs
2024-11-26 Add Module-power
2024-12-01 Cleanup all libs
    - All PCB footprints folders are renamed to *.3dshapes
    - Path to 3D models in the PCB Footprints was harmonized to one path with prefix Z_LIB_3D_DIR (needs to be set as the global variable)
    [Raystar.fcstd]
2024-12-02 Power symbol corrected
    Lib Symbol cannot be used because was in collision with KiCad system lib. Due this was renamed to Power_Symbol. User have to change power symbols in our schematics to new one.
2024-12-09 Add Kingbright 0805 LowProfile LED
2024-12-12 Add G-Switch
2024-12-18 Add PTC fuses
2024-12-31 Update fuse bodies
2025-01-20 Harmonize REFERENCE text in the footprints
2025-09-04 update jumpers, audio connectors.
2025-09-12 Add USB Connector Ninigi
2025-09-25 Add zener diodes
2025-09-29 prepare to next version
    change libs more closer to KiCad KLC ...
2025-10-17 Rename power symbol lib
2025-10-27 Add LEDs
    Add Kingbright THD LED and modify existing footprint names
2025-10-27 Add Power monitor
2025-10-27 Check and fix resistors
    modified library name and some parts moved or created
2025-10-28 Add Apem and Diptronics switch
2025-10-30 Add THD LED 3mm
2025-11-03 Add Vishay Diode
2025-11-03 Modified to step close to Kicad KLC
    fix zero width lines
    fix off-grid pins
    fix footprint masks
2025-11-11 Fix Footprint mask
2025-11-13 Add arduino nano
2025-11-14 Fix wrong number of pin 2
2025-11-14 Change electrical type of pad VBUS and GND
2025-11-18 Fix LPC55xx Powerpins
2025-11-18 Create MountingHole, NPTH, 2.5mm, M2, Clean.kicad_mod
2025-12-16 Add few 1% resistors
2026-03-05 add Optosupplu footprint
2026-06-26 Add THT LEDs
    All THT LEDs from ZElektrik stock were added.
    [L-934MD-1LI1LGD.20260617-143825.FCStd, LEDRD254W50D180H310-2_CVX_FC_LL500_SH100.FCStd, LEDRD254W50D300H500-3_CVX_FDR_LL500_SH160.FCStd, LEDRD254W50D300H500-3_CVX_FD_LL500_SH143.FCStd, LEDRD254W50D300H620-2_CVX_FR_LL500.FCStd, LEDRD254W50D500H860-2_CVX_FD_LL500_SH100.FCStd, LEDRD254W50D500H860-2_CVX_NF_LL500_SH100.FCStd, LEDRD254W50D500H860-3_CVX_FD_LL500_SH175.FCStd]
2026-07-02 prepare to release
    [L-934MD-1LI1LGD.20260617-143825.FCStd, LEDRD254W50D180H310-2_CVX_FC_LL500_SH100.FCStd, LEDRD254W50D300H500-3_CVX_FDR_LL500_SH160.FCStd, LEDRD254W50D300H500-3_CVX_FD_LL500_SH143.FCStd, LEDRD254W50D300H620-2_CVX_FR_LL500.FCStd, LEDRD254W50D500H860-2_CVX_FD_LL500_SH100.FCStd, LEDRD254W50D500H860-2_CVX_NF_LL500_SH100.FCStd, LEDRD254W50D500H860-3_CVX_FD_LL500_SH175.FCStd]
2026-07-08 Add step files
    [L-934MD-1LI1LGD.step, LEDRD254W50D180H310-2_CVX_FC_LL500_SH100_Green.step, LEDRD254W50D180H310-2_CVX_FC_LL500_SH100_Red.step, LEDRD254W50D180H310-2_CVX_FC_LL500_SH100_Yellow.step, LEDRD254W50D290H460-2_CVX_FR_LL500_SH100_Blue.step, LEDRD254W50D290H460-2_CVX_FR_LL500_SH100_Green.step, LEDRD254W50D290H460-2_CVX_FR_LL500_SH100_Orange.step, LEDRD254W50D290H460-2_CVX_FR_LL500_SH100_Red.step]
2026-10-13 1206-Pad-Correction
    One pad of the 1206 packages, has been moved by 0.05mm
